shardikgeek/Greenhouse-Auto/README.md

# Greenhouse-Auto
Proyecto de Técnicas Digitales II
