shardikgeek/Greenhouse-Auto/Hardware.txt

Hardware:

Modulo LCD 20x4
Relay (Bomba)
Modulo Puente H (L298M para fan)
Motor paso a paso
Botones
Sensor de humedad del suelo (YL-69)
Sensor de humedad relativa y temperatura (Dht22)
Reloj RTC
