shardikgeek/Greenhouse-Auto/Comandos/Comandos_SAI.docx

Comando | Paquete | Función
Iniciar | :INI,-,-! | Inicia la conversación.
Stop | :STP,-,- | Termina la conversación.
Monitor | :MON,-,ON | Activa el modo monitor.
Monitor | :MON,-,OFF | Desactiva el modo monitor.
Tarjeta presente | :SDC,-,- | Verifica si la tarjeta SD está o no puesta.
Activar cultivo | :TOM,-,- | Comienza el seguimiento de tomate
Activar cultivo | :ZAN,-,- | Comienza el seguimiento de la zanahoria
Modificar temperaturas | :MOD_TEMP,-,ETAPA XX TIPO XX MAX_FAN XX MIN_FAN XX MIN_CAL XX MAX_CAL XX! | Modifica las temperaturas objetivo de una etapa.
Modificar minutos tomate | :MOD_MIN_T,-,E0 XX E1 XX E2 XX! | Modifica los minutos que dura cada etapa.
Modificar minutos zanahoria | :MOD_MIN_Z,-,E0 XX E1 XX E2 XX! | Modifica los minutos que dura la zanahora.
Check temperaturas | :CK_TEMP,-,TOM! | Muestra las temperaturas objetivo de las etapas.
Check minutos | :CK_MIN,-,TOM! | Muestra los minutos de las etapas.
Parar seguimiento | :PAUSE,-,-! | Para el control de temperatura y humedad del seguimiento
Continuar seguimiento | :CONTINUE,-,-! | Habilita el control de temperatura y humedad del seguimiento.
Fecha | :DAY,2,YEAR xx MON xx DATE xx DAY xx HOUR xx MIN xx SEC xx! | Cambia la hora del sistema.
Ventana | :VENT0,-,- | Abrir ventana
Ventana | :VENTC,-,- | Cerrar ventana
Ventana | :STOPV,-,- | Parar ventana
Ventilador | :FAN,-,ON | Prender ventilador
Ventilador | :FAN,-,OFF | Apagar ventilador
Calentador | :CAL,-,ON | Prender calentador
Calentador | :CAL,-,OFF | Apagar calentador
Bomba | :BOMBA,-,ON | Prender Bomba
Bomba | :BOMBA,-,OFF | Apagar Bomba
