shardikgeek/Greenhouse-Auto/Pruebas/Pruebas.md

En esta carpeta se encuentran los codigos para probar cada elemento por separado.
