shardikgeek/Greenhouse-Auto/Pruebas/STM32/STM32.md

Codigos ejemplo y prubeas para la Discovery.
