shardikgeek/Greenhouse-Auto/Pruebas/Maquinas de estado/FSM-MENU.xls

Sheet: State_Table
 |  |  |  | Number of states: |  | 19
 |  |  |  | Number of events: |  | 5
 | menu |  | enter |  | arriba |  | abajo |  | back |  | Event5 |  | Event6 |  | Event7 |  | Event8 |  | Event9 |  | Event10 |  | Event11 |  | Event12 |  | Event13 |  | Event14 |  | Event15 |  | Event16 |  | Event17 |  | Event18 |  | Event19 |  | Event20 |  | Event21 |  | Event22 |  | Event23 |  | Event24 |  | Event25 |  | Event26 |  | Event27 |  | Event28 |  | Event29
 | Function | Next State | Function | Next State | Function | Next State | Function | Next State | Function | Next State | Function | Next State | Function | Next State | Function | Next State | Function | Next State | Function | Next State | Function | Next State | Function | Next State | Function | Next State | Function | Next State | Function | Next State | Function | Next State | Function | Next State | Function | Next State | Function | Next State | Function | Next State | Function | Next State | Function | Next State | Function | Next State | Function | Next State | Function | Next State | Function | Next State | Function | Next State | Function | Next State | Function | Next State | Function
menu_desactivado |  | cultivo |  | menu_desactivado |  | menu_desactivado |  | menu_desactivado |  | menu_desactivado
cultivo |  | menu_desactivado |  | nuevo_cultivo |  | cultivo |  | variables |  | menu_desactivado
variables |  | menu_desactivado |  | humedad |  | cultivo |  | control |  | menu_desactivado
control |  | menu_desactivado |  | bomba |  | variables |  | exportar |  | menu_desactivado
exportar |  | menu_desactivado |  | log |  | control |  | exportar |  | menu_desactivado
nuevo_cultivo |  | menu_desactivado |  | tomate |  | nuevo_cultivo |  | pausar |  | cultivo
pausar |  | menu_desactivado | f_pausar | pausar |  | nuevo_cultivo |  | cancelar |  | cultivo
cancelar |  | menu_desactivado | f_cancelar | cancelar |  | pausar |  | cancelar |  | cultivo
tomate |  | menu_desactivado | f_tomate | tomate |  | tomate |  | zanahoria |  | nuevo_cultivo
zanahoria |  | menu_desactivado | f_zanahoria | zanahoria |  | tomate |  | zanahoria |  | nuevo_cultivo
humedad |  | menu_desactivado | f_humedad | humedad |  | humedad |  | temp_ext |  | variables
temp_ext |  | menu_desactivado | f_temp_ext | temp_ext |  | humedad |  | temp_int |  | variables
temp_int |  | menu_desactivado | f_temp_int | temp_int |  | temp_ext |  | temp_int |  | variables
bomba |  | menu_desactivado | f_bomba | bomba |  | bomba |  | calentador |  | control
calentador |  | menu_desactivado | f_calentador | calentador |  | bomba |  | ventana |  | control
ventana |  | menu_desactivado | f_ventana | ventana |  | calentador |  | ventilador |  | control
ventilador |  | menu_desactivado | f_ventilador | ventilador |  | ventana |  | ventilador |  | control
log |  | menu_desactivado | f_log | log |  | log |  | etapas |  | exportar
etapas |  | menu_desactivado | f_etapas | etapas |  | log |  | etapas |  | exportar
State19
State20
State21
State22
State23
State24
State25
State26
State27
State28
State29
State30
State31

Sheet: fsm_c
//****************************************************************************//
// MSP430 state machine
// fsm.c
//
// Describtion:
// A simple state machine for the MSP430
// Do not change code in here!!!
//
// Generated with Excel Table
// Date: 11/26/2018 Time: 17:47:56
//
//****************************************************************************//
#include <stdint.h>
#include <stdio.h>
#include "fsm.h"
//****************************************************************************//
// Global variables
//****************************************************************************//
uint8_t ActState;
const FSM_STATE_TABLE StateTable [NR_STATES][NR_EVENTS] =
{
NULL, CULTIVO, NULL, MENU_DESACTIVADO, NULL, MENU_DESACTIVADO, NULL, MENU_DESACTIVADO, NULL, MENU_DESACTIVADO,
NULL, MENU_DESACTIVADO, NULL, NUEVO_CULTIVO, NULL, CULTIVO, NULL, VARIABLES, NULL, MENU_DESACTIVADO,
NULL, MENU_DESACTIVADO, NULL, HUMEDAD, NULL, CULTIVO, NULL, CONTROL, NULL, MENU_DESACTIVADO,
NULL, MENU_DESACTIVADO, NULL, BOMBA, NULL, VARIABLES, NULL, EXPORTAR, NULL, MENU_DESACTIVADO,
NULL, MENU_DESACTIVADO, NULL, LOG, NULL, CONTROL, NULL, EXPORTAR, NULL, MENU_DESACTIVADO,
NULL, MENU_DESACTIVADO, NULL, TOMATE, NULL, NUEVO_CULTIVO, NULL, PAUSAR, NULL, CULTIVO,
NULL, MENU_DESACTIVADO, FSM_f_pausar, PAUSAR, NULL, NUEVO_CULTIVO, NULL, CANCELAR, NULL, CULTIVO,
NULL, MENU_DESACTIVADO, FSM_f_cancelar, CANCELAR, NULL, PAUSAR, NULL, CANCELAR, NULL, CULTIVO,
NULL, MENU_DESACTIVADO, FSM_f_tomate, TOMATE, NULL, TOMATE, NULL, ZANAHORIA, NULL, NUEVO_CULTIVO,
NULL, MENU_DESACTIVADO, FSM_f_zanahoria, ZANAHORIA, NULL, TOMATE, NULL, ZANAHORIA, NULL, NUEVO_CULTIVO,
NULL, MENU_DESACTIVADO, FSM_f_humedad, HUMEDAD, NULL, HUMEDAD, NULL, TEMP_EXT, NULL, VARIABLES,
NULL, MENU_DESACTIVADO, FSM_f_temp_ext, TEMP_EXT, NULL, HUMEDAD, NULL, TEMP_INT, NULL, VARIABLES,
NULL, MENU_DESACTIVADO, FSM_f_temp_int, TEMP_INT, NULL, TEMP_EXT, NULL, TEMP_INT, NULL, VARIABLES,
NULL, MENU_DESACTIVADO, FSM_f_bomba, BOMBA, NULL, BOMBA, NULL, CALENTADOR, NULL, CONTROL,
NULL, MENU_DESACTIVADO, FSM_f_calentador, CALENTADOR, NULL, BOMBA, NULL, VENTANA, NULL, CONTROL,
NULL, MENU_DESACTIVADO, FSM_f_ventana, VENTANA, NULL, CALENTADOR, NULL, VENTILADOR, NULL, CONTROL,
NULL, MENU_DESACTIVADO, FSM_f_ventilador, VENTILADOR, NULL, VENTANA, NULL, VENTILADOR, NULL, CONTROL,
NULL, MENU_DESACTIVADO, FSM_f_log, LOG, NULL, LOG, NULL, ETAPAS, NULL, EXPORTAR,
NULL, MENU_DESACTIVADO, FSM_f_etapas, ETAPAS, NULL, LOG, NULL, ETAPAS, NULL, EXPORTAR
};
//****************************************************************************//
// Initialize state machine
//****************************************************************************//
void FSM_Init (void)
{
ActState = MENU_DESACTIVADO;
}
//****************************************************************************//
// Event function "menu"
//****************************************************************************//
void FSM_menu (void)
{
if (StateTable[ActState][MENU].ptrFunct != NULL)
StateTable[ActState][MENU].ptrFunct();
ActState = StateTable[ActState][MENU].NextState;
}
//****************************************************************************//
// Event function "enter"
//****************************************************************************//
void FSM_enter (void)
{
if (StateTable[ActState][ENTER].ptrFunct != NULL)
StateTable[ActState][ENTER].ptrFunct();
ActState = StateTable[ActState][ENTER].NextState;
}
//****************************************************************************//
// Event function "arriba"
//****************************************************************************//
void FSM_arriba (void)
{
if (StateTable[ActState][ARRIBA].ptrFunct != NULL)
StateTable[ActState][ARRIBA].ptrFunct();
ActState = StateTable[ActState][ARRIBA].NextState;
}
//****************************************************************************//
// Event function "abajo"
//****************************************************************************//
void FSM_abajo (void)
{
if (StateTable[ActState][ABAJO].ptrFunct != NULL)
StateTable[ActState][ABAJO].ptrFunct();
ActState = StateTable[ActState][ABAJO].NextState;
}
//****************************************************************************//
// Event function "back"
//****************************************************************************//
void FSM_back (void)
{
if (StateTable[ActState][BACK].ptrFunct != NULL)
StateTable[ActState][BACK].ptrFunct();
ActState = StateTable[ActState][BACK].NextState;
}
//****************************************************************************//

Sheet: fsm_transition_c
//****************************************************************************//
// MSP430 state machine
// fsm_transition.c
//
// Describtion:
// A simple state machine for the MSP430
// You can add your own code in here!!!
//
// Generated with Excel Table
// Date: 11/26/2018 Time: 17:47:56
//
//****************************************************************************//
#include "fsm.h"
//****************************************************************************//
// Transition function "f_pausar"
//****************************************************************************//
void FSM_f_pausar (void)
{
// You can add your code here
}
//****************************************************************************//
// Transition function "f_cancelar"
//****************************************************************************//
void FSM_f_cancelar (void)
{
// You can add your code here
}
//****************************************************************************//
// Transition function "f_tomate"
//****************************************************************************//
void FSM_f_tomate (void)
{
// You can add your code here
}
//****************************************************************************//
// Transition function "f_zanahoria"
//****************************************************************************//
void FSM_f_zanahoria (void)
{
// You can add your code here
}
//****************************************************************************//
// Transition function "f_humedad"
//****************************************************************************//
void FSM_f_humedad (void)
{
// You can add your code here
}
//****************************************************************************//
// Transition function "f_temp_ext"
//****************************************************************************//
void FSM_f_temp_ext (void)
{
// You can add your code here
}
//****************************************************************************//
// Transition function "f_temp_int"
//****************************************************************************//
void FSM_f_temp_int (void)
{
// You can add your code here
}
//****************************************************************************//
// Transition function "f_bomba"
//****************************************************************************//
void FSM_f_bomba (void)
{
// You can add your code here
}
//****************************************************************************//
// Transition function "f_calentador"
//****************************************************************************//
void FSM_f_calentador (void)
{
// You can add your code here
}
//****************************************************************************//
// Transition function "f_ventana"
//****************************************************************************//
void FSM_f_ventana (void)
{
// You can add your code here
}
//****************************************************************************//
// Transition function "f_ventilador"
//****************************************************************************//
void FSM_f_ventilador (void)
{
// You can add your code here
}
//****************************************************************************//
// Transition function "f_log"
//****************************************************************************//
void FSM_f_log (void)
{
// You can add your code here
}
//****************************************************************************//
// Transition function "f_etapas"
//****************************************************************************//
void FSM_f_etapas (void)
{
// You can add your code here
}
//****************************************************************************//

Sheet: fsm_h
//****************************************************************************//
// MSP430 state machine
// fsm.h
//
// Describtion:
// A simple state machine for the MSP430
//
// Generated with Excel Table
// Date: 11/26/2018 Time: 17:47:56
//
//****************************************************************************//
#ifndef FSM_H
#define FSM_H
#include <stdint.h>
#include <stdio.h>
//****************************************************************************//
// State table typedef
//****************************************************************************//
typedef struct
{
void (*ptrFunct) (void);
uint8_t NextState;
} FSM_STATE_TABLE;
extern uint8_t ActState;
#define NR_EVENTS 5
#define MENU 0
#define ENTER 1
#define ARRIBA 2
#define ABAJO 3
#define BACK 4
#define NR_STATES 19
#define MENU_DESACTIVADO 0
#define CULTIVO 1
#define VARIABLES 2
#define CONTROL 3
#define EXPORTAR 4
#define NUEVO_CULTIVO 5
#define PAUSAR 6
#define CANCELAR 7
#define TOMATE 8
#define ZANAHORIA 9
#define HUMEDAD 10
#define TEMP_EXT 11
#define TEMP_INT 12
#define BOMBA 13
#define CALENTADOR 14
#define VENTANA 15
#define VENTILADOR 16
#define LOG 17
#define ETAPAS 18
//****************************************************************************//
// Function prototypes
//****************************************************************************//
// Initialize state machine
void FSM_Init (void);
// Event function "menu"
void FSM_menu (void);
// Event function "enter"
void FSM_enter (void);
// Event function "arriba"
void FSM_arriba (void);
// Event function "abajo"
void FSM_abajo (void);
// Event function "back"
void FSM_back (void);
// Transition function "f_pausar"
void FSM_f_pausar (void);
// Transition function "f_cancelar"
void FSM_f_cancelar (void);
// Transition function "f_tomate"
void FSM_f_tomate (void);
// Transition function "f_zanahoria"
void FSM_f_zanahoria (void);
// Transition function "f_humedad"
void FSM_f_humedad (void);
// Transition function "f_temp_ext"
void FSM_f_temp_ext (void);
// Transition function "f_temp_int"
void FSM_f_temp_int (void);
// Transition function "f_bomba"
void FSM_f_bomba (void);
// Transition function "f_calentador"
void FSM_f_calentador (void);
// Transition function "f_ventana"
void FSM_f_ventana (void);
// Transition function "f_ventilador"
void FSM_f_ventilador (void);
// Transition function "f_log"
void FSM_f_log (void);
// Transition function "f_etapas"
void FSM_f_etapas (void);
//****************************************************************************//
#endif /* FSM_H */
//****************************************************************************//
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
