shardikgeek/Greenhouse-Auto/(list of files, drawings)

Other design files:
Proteus/Placa Madre/Placa Madre.pdsprj
Proteus/Placas Finales/Primera-Placa.pdsprj
Proteus/Placas Finales/Segunda-Placa.pdsprj
Proteus/Reporte_Avance_Alvarez_Loidi_2018_FRBB/Esquematico_Alvarez_Loidi_TDII.pdsprj
