shardikgeek/Greenhouse-Auto/Codigo/SAI_Beta1.0/src/main.c

#include "main.h"

int contador_led = 1000;


int main(void){

	/*	Prototipo 1.3
	 *	Este programa es un prototipo del control de invernadero.
	 *	Tiene RTC, una prueba de seguimiento de cultivos, lee dos sensores externos de temperatura y humedad
	 *	y dos analogicos. 
	 *
	 */

	UB_LCD_2x16_Init(); // Inicializacion del display.
	inicializar_leds();
	inicializar_fan();
	inicializar_ventana();
	inicializar_calentador();
	inicializar_bomba();
	inicializar_nivel_agua();
	adc_inicializar();
	TIM5_Start(); // Inicializa el timer del DHT.
	TIM3_Start(); // Inicializa el timer para el motor paso a paso.
	USART3_Config();

	TM_RTC_Init(TM_RTC_ClockSource_External); // Se inicializa el RTC.
	TM_RTC_Interrupts(TM_RTC_Int_1s); //Se activan las interrupciones del RTC.

	SystemInit(); // Activa el systick.
	SysTick_Config(SystemCoreClock / 1e3); // Configuracion del tiempo de la interrupcion (cada 1us).
	UB_Fatfs_Init(); // Init de la SD.
	FSM_Init(); // Se inicializa la maquina de estados del menu.
	inicializar_botones(); // Inicializa los botones.

	serial.contador = 0;
	serial.flag.comienzo_paquete = 0;
	serial.flag.fin_paquete = 0;
	serial.timeout = 0;
	sistema.flag.conexion_serial = 0;
	sistema.flag.modo_monitor_serial = 0;

	ldr.contador_promedio = 0; // Reset del contador.
	ldr.adc_cuentas_temp = 0; // Reset de la suma del promedio.
	ldr.contador = 101; 		//Cada 5 ms

	tarjeta_sd.flag.fallo_abrir_archivo = 0;
	cultivo.flag.control_activo = 0;
	cargar_datos(); // Se cargan los datos por default.

	control.flag.ventana_abierta = 0;
	control.flag.fan_encendido = 0;
	control.flag.bomba_encendida = 0;
	control.flag.calentador_encendido = 0;
	display.refresh_time = 2001;
	// Offsets de tareas.
	dht_interior.contador = 2501;
	dht_exterior.contador = 3001;
	led.contador = contador_led;
	serial.contador_task = 2501;

	while(1){
		task_manager();
	}
}


/// INICIALIZAIONES

void inicializar_botones(){
	//
	//Inicializacion de los botones.
	//

	GPIO_InitTypeDef GPIO_Init_Pins; // Estrucura de datos para configurar el GPIO

	RCC_AHB1PeriphClockCmd(RCC_AHB1Periph_GPIOD, ENABLE);

	GPIO_Init_Pins.GPIO_Pin = GPIO_Pin_1 + GPIO_Pin_5 + GPIO_Pin_3 + GPIO_Pin_6 + GPIO_Pin_7;
	GPIO_Init_Pins.GPIO_Mode = GPIO_Mode_IN; //Entrada
	GPIO_Init_Pins.GPIO_Speed = GPIO_Speed_100MHz;
	GPIO_Init_Pins.GPIO_OType= GPIO_OType_PP;
	GPIO_Init_Pins.GPIO_PuPd = GPIO_PuPd_UP;

	GPIO_Init(GPIOD, &GPIO_Init_Pins);// Carga de la estrucura de datos.
}

void inicializar_nivel_agua(){
	//
	//Inicializacion de los botones.
	//

	GPIO_InitTypeDef GPIO_Init_Pins; // Estrucura de datos para configurar el GPIO

	RCC_AHB1PeriphClockCmd(RCC_AHB1Periph_GPIOC, ENABLE);

	GPIO_Init_Pins.GPIO_Pin = GPIO_Pin_6;
	GPIO_Init_Pins.GPIO_Mode = GPIO_Mode_IN; //Entrada
	GPIO_Init_Pins.GPIO_Speed = GPIO_Speed_100MHz;
	GPIO_Init_Pins.GPIO_OType= GPIO_OType_PP;
	GPIO_Init_Pins.GPIO_PuPd = GPIO_PuPd_UP;

	GPIO_Init(GPIOC, &GPIO_Init_Pins);// Carga de la estrucura de datos.
}




void inicializar_leds(){
	/*	Funcion inicializar_leds()
	 *	No recive ni devuelve un valor.
	 *	Se inicializan los 4 leds de la placa Discovery STM32F4.
	 */

	GPIO_InitTypeDef GPIO_Init_Pins; // Estrucura de datos para configurar el GPIO

	//
	//Inicializacion de los leds.
	//

	RCC_AHB1PeriphClockCmd(RCC_AHB1Periph_GPIOD, ENABLE);

	GPIO_Init_Pins.GPIO_Pin= GPIO_Pin_15 |GPIO_Pin_12 | GPIO_Pin_13;
	GPIO_Init_Pins.GPIO_Mode=GPIO_Mode_OUT ;
	GPIO_Init_Pins.GPIO_Speed= GPIO_Speed_100MHz;
	GPIO_Init_Pins.GPIO_OType= GPIO_OType_PP ;
	GPIO_Init_Pins.GPIO_PuPd= GPIO_PuPd_NOPULL;

	GPIO_Init(GPIOD,&GPIO_Init_Pins); // Carga de la estrucura de datos.

}

void inicializar_fan(){
	/*	Funcion inicializar_leds()
	 *	No recive ni devuelve un valor.
	 *	Se inicializan los 4 leds de la placa Discovery STM32F4.
	 */

	GPIO_InitTypeDef GPIO_Init_Pins; // Estrucura de datos para configurar el GPIO

	//
	//Inicializacion de los leds.
	//

	RCC_AHB1PeriphClockCmd(RCC_AHB1Periph_GPIOD, ENABLE);

	GPIO_Init_Pins.GPIO_Pin= GPIO_Pin_14;
	GPIO_Init_Pins.GPIO_Mode=GPIO_Mode_OUT ;
	GPIO_Init_Pins.GPIO_Speed= GPIO_Speed_100MHz;
	GPIO_Init_Pins.GPIO_OType= GPIO_OType_PP ;
	GPIO_Init_Pins.GPIO_PuPd= GPIO_PuPd_NOPULL;

	GPIO_Init(GPIOD,&GPIO_Init_Pins); // Carga de la estrucura de datos.

}

void inicializar_ventana()
{
	GPIO_InitTypeDef GPIOA_Stepper;
	RCC_AHB1PeriphClockCmd(RCC_AHB1Periph_GPIOA, ENABLE);

	GPIOA_Stepper.GPIO_Mode = GPIO_Mode_OUT;
	GPIOA_Stepper.GPIO_OType = GPIO_OType_PP;
	GPIOA_Stepper.GPIO_Pin = GPIO_Pin_10|GPIO_Pin_13|GPIO_Pin_14|GPIO_Pin_15;
	GPIOA_Stepper.GPIO_PuPd = GPIO_PuPd_NOPULL;
	GPIOA_Stepper.GPIO_Speed = GPIO_Speed_50MHz;
	GPIO_Init(GPIOA,&GPIOA_Stepper);
}

void inicializar_calentador(){
	/*	Funcion inicializar_leds()
	 *	No recive ni devuelve un valor.
	 *	Se inicializan los 4 leds de la placa Discovery STM32F4.
	 */

	GPIO_InitTypeDef GPIO_Init_Pins; // Estrucura de datos para configurar el GPIO

	//
	//Inicializacion de los leds.
	//

	RCC_AHB1PeriphClockCmd(RCC_AHB1Periph_GPIOC, ENABLE);

	GPIO_Init_Pins.GPIO_Pin= GPIO_Pin_4;
	GPIO_Init_Pins.GPIO_Mode=GPIO_Mode_OUT ;
	GPIO_Init_Pins.GPIO_Speed= GPIO_Speed_100MHz;
	GPIO_Init_Pins.GPIO_OType= GPIO_OType_PP ;
	GPIO_Init_Pins.GPIO_PuPd= GPIO_PuPd_NOPULL;

	GPIO_Init(GPIOC,&GPIO_Init_Pins); // Carga de la estrucura de datos.

}

void inicializar_bomba(){
	/*	Funcion inicializar_leds()
	 *	No recive ni devuelve un valor.
	 *	Se inicializan los 4 leds de la placa Discovery STM32F4.
	 */

	GPIO_InitTypeDef GPIO_Init_Pins; // Estrucura de datos para configurar el GPIO

	//
	//Inicializacion de los leds.
	//

	RCC_AHB1PeriphClockCmd(RCC_AHB1Periph_GPIOC, ENABLE);

	GPIO_Init_Pins.GPIO_Pin= GPIO_Pin_5;
	GPIO_Init_Pins.GPIO_Mode=GPIO_Mode_OUT ;
	GPIO_Init_Pins.GPIO_Speed= GPIO_Speed_100MHz;
	GPIO_Init_Pins.GPIO_OType= GPIO_OType_PP ;
	GPIO_Init_Pins.GPIO_PuPd= GPIO_PuPd_NOPULL;

	GPIO_Init(GPIOC,&GPIO_Init_Pins); // Carga de la estrucura de datos.

}


static void USART3_Config(void)
{
	/*	Funcion USART3_Config
	 * 	Configura los pines necesarios para la conexion a traves de RS232.
	 * 	Ademas inicializa las interrupciones para el USART3 en modo recepcion.
	 */
	GPIO_InitTypeDef GPIO_InitStructure;
	USART_InitTypeDef USART_InitStructure;
	/* USART IOs configuration ***********************************/
	/* Enable GPIOC clock */
	RCC_AHB1PeriphClockCmd(RCC_AHB1Periph_GPIOD, ENABLE);
	/* Connect PC10 to USART3_Tx */
	GPIO_PinAFConfig(GPIOD, GPIO_PinSource8, GPIO_AF_USART3);
	/* Connect PC11 to USART3_Rx*/
	GPIO_PinAFConfig(GPIOD, GPIO_PinSource9, GPIO_AF_USART3);
	/* Configure USART3_Tx and USART3_Rx as alternate function */
	GPIO_InitStructure.GPIO_Pin = GPIO_Pin_8 | GPIO_Pin_9;
	GPIO_InitStructure.GPIO_Mode = GPIO_Mode_AF;
	GPIO_InitStructure.GPIO_Speed = GPIO_Speed_100MHz; // estaba en 50MHz
	GPIO_InitStructure.GPIO_OType = GPIO_OType_PP;
	GPIO_InitStructure.GPIO_PuPd = GPIO_PuPd_UP;
	GPIO_Init(GPIOD, &GPIO_InitStructure);
	/* USART configuration ***************************************/
	/* USART3 configured as follow:
- BaudRate = 115200 baud
- Word Length = 8 Bits
- One Stop Bit
- No parity
- Hardware flow control disabled (RTS and CTS signals)
- Receive and transmit enabled
	 */
	/* Enable USART3 clock */
	RCC_APB1PeriphClockCmd(RCC_APB1Periph_USART3, ENABLE);
	USART_InitStructure.USART_BaudRate = 9600;
	USART_InitStructure.USART_WordLength = USART_WordLength_8b;
	USART_InitStructure.USART_StopBits = USART_StopBits_1;
	USART_InitStructure.USART_Parity = USART_Parity_No;
	USART_InitStructure.USART_HardwareFlowControl = USART_HardwareFlowControl_None;
	USART_InitStructure.USART_Mode = USART_Mode_Rx | USART_Mode_Tx;
	USART_Init(USART3, &USART_InitStructure);
	/* Enable USART3 */
	USART_Cmd(USART3, ENABLE);

	//USART1 is more important than USART2, so it has lower sub priority number
	NVIC_InitTypeDef NVIC_InitStruct;

	NVIC_InitStruct.NVIC_IRQChannel = USART3_IRQn;
	NVIC_InitStruct.NVIC_IRQChannelCmd = ENABLE;
	NVIC_InitStruct.NVIC_IRQChannelPreemptionPriority = 10;
	NVIC_InitStruct.NVIC_IRQChannelSubPriority = 0;
	NVIC_Init(&NVIC_InitStruct);

	USART_ITConfig(USART3, USART_IT_RXNE, ENABLE); // Se habilitan las interrupciones cuando se recibe un dato.
}
///

///	Tareas

void task_scheduler(void){
	/*	Funcion task_scheduler()
	 *	Maneja los contadores de las distintas tareas. Esta funcion es llamada por el systick cada
	 *	vez que se vence su contador (1ms en este caso).
	 *	Cuando el ontador de una tarea llega a su, fin se dispara una bandera de evento.
	 *	Este evento es chequeado luego de la interrupcion generada por el systick en el main().
	 *	Puede haber dos tipos de tareas, ciclicas o no ciclicas. En las ciclicas el
	 *	contador se resetea cada vez q una tarea finaliza, en las no ciclicas el contador
	 *	se setea solo cuando es necesario.
	 */

	// BOTONES
	if(dht_interior.flag == 0 && dht_exterior.flag == 0 && display.flag == 0 && serial.flag.mostrar_valores == 0){

		if(!GPIO_ReadInputDataBit(GPIOD, GPIO_Pin_3))
		{
			if(botones.contador_menu < 15){
				botones.contador_menu++;
				botones.flag.fin_menu = 0;
			}
		}
		else{
			if(botones.contador_menu >= 15){
					GPIO_ToggleBits(GPIOD,GPIO_Pin_15);
					FSM_menu();
					display.flag = 1;
					botones.contador_menu = 0;
					botones.flag.fin_menu = 1; // boton presionado.
			}
		}

		if(!GPIO_ReadInputDataBit(GPIOD, GPIO_Pin_6)){
			if(botones.contador_down < 15){
				botones.contador_down++;
				botones.flag.fin_down = 0; // boton presionado.
			}
		}
		else{
			if(botones.contador_down >= 15){
				GPIO_ToggleBits(GPIOD,GPIO_Pin_15);
				FSM_abajo();
				display.flag = 1;
				botones.contador_down = 0;
				botones.flag.fin_down = 1; // boton presionado.
			}
		}

		if(!GPIO_ReadInputDataBit(GPIOD, GPIO_Pin_5))
		{
			if(botones.contador_back < 15){
				botones.contador_back++;
			}
		}
		else{
			if(botones.contador_back >= 15){
				GPIO_ToggleBits(GPIOD,GPIO_Pin_15);
				FSM_back();
				display.flag = 1;
				botones.contador_back = 0;
				botones.flag.fin_back = 0; // boton presionado.
			}
		}
		if(!GPIO_ReadInputDataBit(GPIOD, GPIO_Pin_7))
		{
			if(botones.contador_up < 15){
				botones.contador_up++;
			}
		}
		else{
			if(botones.contador_up >= 15){
				GPIO_ToggleBits(GPIOD,GPIO_Pin_15);
				FSM_arriba();
				display.flag = 1;
				botones.contador_up = 0;
				botones.flag.fin_up = 0; // boton presionado.
			}
		}

		if(!GPIO_ReadInputDataBit(GPIOD, GPIO_Pin_1))
		{
			if(botones.contador_enter < 15){
				botones.contador_enter++;
			}
		}
		else{
			if(botones.contador_enter >= 15){
				GPIO_ToggleBits(GPIOD,GPIO_Pin_15);
				FSM_enter();
				display.flag = 1;
				botones.contador_enter = 0;
				botones.flag.fin_enter = 0; // boton presionado.
			}
		}

		if((botones.contador_menu + botones.contador_down + botones.contador_up + botones.contador_back + botones.contador_enter) >= 30){
			GPIO_SetBits(GPIOD,GPIO_Pin_12); // Se enciende el led verde si se apretan los botones a la vez.
		}
		else{
			GPIO_ResetBits(GPIOD,GPIO_Pin_12); // Se apaga el led si no se presiona el led o se apreta de a uno a la vez.

		}

		//Nivel de agua.
		if(!GPIO_ReadInputDataBit(GPIOC, GPIO_Pin_6))
		{
			control.flag.agua_tanque = 1;
		}
		else{
			control.flag.agua_tanque = 0;
		}
	}

	//	// Rutina DHT
	if(dht_interior.flag){
		if(dht_interior.timeout >= 1){
			dht_interior.timeout--;
		}

		if(dht_interior.timeout <= 0){
			dht_interior.flag_timeout = 1;
		}
	}

	if(dht_interior.contador >= 1){
		dht_interior.contador--;
	}
	else{
		dht_interior.flag = 1;
		dht_interior.contador = 2501;
		dht_interior.flag_timeout = 0;
		dht_interior.timeout = 1001; // Se le agrega un tiempo de timeout para esperar la funcion DHT11Start.
	}

	if(dht_exterior.flag){
		if(dht_exterior.timeout >= 1){
			dht_exterior.timeout--;
		}

		if(dht_exterior.timeout <= 0){
			dht_exterior.flag_timeout = 1;
		}
	}

	if(dht_exterior.contador >= 1){
		dht_exterior.contador--;
	}
	else{
		dht_exterior.flag = 1;
		dht_exterior.contador = 2501;
		dht_exterior.flag_timeout = 0;
		dht_exterior.timeout = 1001; // Se le agrega un tiempo de timeout para esperar la funcion DHT11Start.
	}
	//
	// Rutina LDR
	if(ldr.contador >= 1){
		ldr.contador--;
	}
	else{
		ldr.flag.fin_contador = 1;
		ldr.contador = 101; 		//Cada 100 mseg
	}

	// Ruitna YL-69
	if(yl.contador >= 1){
		yl.contador--;
	}
	else{
		yl.flag = 1;
		yl.contador = 101;
	}

	// Rutina del LED.
	if(led.contador >= 1){
		led.contador--;
	}
	else{
		led.flag.fin_contador = (led.flag.fin_contador) ? 0 : 1;
		led.contador = contador_led;
	}

	// Rutina display.
	if(display.contador >= 1){
		display.contador--;
	}
	else{
		display.flag = 1;
		display.contador = display.refresh_time;
	}

	// Rutina Serial.
	if(serial.timeout >= 1){
		serial.timeout--;
	}
	else if(serial.flag.comienzo_paquete){
		serial.flag.comienzo_paquete = 0;
		enviar_comando(":TMO,-,-!");
	}

	// Contador para el modo monitor
	if(serial.contador_task >= 1){
		serial.contador_task--;
	}
	else if(sistema.flag.modo_monitor_serial){
		serial.contador_task = 1001;
		serial.flag.mostrar_valores = 1;
	}

	// Contador para chequear cultivo.
	if(cultivo.contador_aux >= 1 && cultivo.flag.control_activo){
		cultivo.contador_aux--;
	}
	else if(cultivo.flag.control_activo){
		cultivo.flag.fin_contador = 1;
		cultivo.contador_aux = 10e3 + 1;
	}
}

void task_manager(void){
	/*	Funcion task_manager
	 *	No recive ni devuelve un valor.
	 * 	Se encarga de llamar a las distintas tareas del programa.
	 *	Estas tareas se realizan o no dependiendo de su flag de evento.
	 */

	menu_task();
//	}else{
//		GPIO_ResetBits(GPIOD,GPIO_Pin_13);
//	}

	// Lectura de datos
	dht_interior_task();
	dht_exterior_task();
	ldr_task();
	yl69_task();
	serial_task();
	display_task(); 		// Manejo de la interfaz de usuario.
	ventana_task();

	// Otras tareas.
	if(!sistema.flag.conexion_serial){ // Se realizan las tareas si no se esta conectado al serial
		led_task();

		// Si se cambia de etapa se cambia el archivo de log.
		if(cultivo.flag.cambio_etapa){
			log_etapas();
			cultivo.flag.cambio_etapa = 0;
		}
	}

	if(cultivo.flag.control_activo){
		if(cultivo.flag.fin_contador){
			datalogger_mejorado();
			cultivo.flag.fin_contador = 0;
		}
		if(!cultivo.flag.pause){
			control_temp_task();
			control_hum_task();
		}
	}



	//	// Si hay una plantacion activa, se controla la temperatura.
	//	if(cultivo.flag.fin_contador){
	//		check_cultivo_task();
	//		cultivo.flag.fin_contador = 0;
	//	}
	//
	//	if(cultivo.flag.control_activo){
	//		control_temp_task();
	//	}
}

void menu_task(){
	char buffer[16];

	if(menu_flags.f_pausa){

		if(cultivo.flag.pause){
			cultivo.flag.pause = 0;
			UB_LCD_2x16_String(0,0,"PAUSA            ");
			UB_LCD_2x16_String(0,1,"DESACTIVADA      ");
			display.contador = 2001;
		}
		else{
			cultivo.flag.pause = 1;
			UB_LCD_2x16_String(0,0,"PAUSA            ");
			UB_LCD_2x16_String(0,1,"ACTIVADA         ");
			if(control.flag.fan_encendido){
				apagar_ventilador();
			}
			if(control.flag.ventana_abierta){
				cerrar_ventana();
			}
			if(control.flag.calentador_encendido){
				GPIO_ResetBits(GPIOC,GPIO_Pin_4);
			}
			if(control.flag.bomba_encendida){
				GPIO_ResetBits(GPIOC,GPIO_Pin_5);
			}

			display.contador = 2001;
		}

		menu_flags.f_pausa = 0;
	}
	if(menu_flags.f_cancelar){
		UB_LCD_2x16_String(0,0,"Cancelar         ");
		UB_LCD_2x16_String(0,1,"                 ");
		display.contador = 2001;
		cultivo.flag.control_activo = 0;
		log_etapas();
		menu_flags.f_cancelar = 0;
	}
	if(menu_flags.f_tomate){
		UB_LCD_2x16_String(0,0,"Configurando     ");
		UB_LCD_2x16_String(0,1,"Tomate           ");
		display.contador = 2001;
		configurar_cultivo_tomate();
		menu_flags.f_tomate = 0;
	}
	if(menu_flags.f_zanahoria){
		UB_LCD_2x16_String(0,0,"Configurando     ");
		UB_LCD_2x16_String(0,1,"Zanahoria        ");
		display.contador = 2001;
		configurar_cultivo_zanahoria();
		menu_flags.f_zanahoria = 0;
	}
	if(menu_flags.f_humedad){
		sprintf(buffer,"Humedad: %d%%  ", yl.humedad);
		UB_LCD_2x16_String(0,0,buffer);
		UB_LCD_2x16_String(0,1,"                 ");
		display.contador = 2001;
		menu_flags.f_humedad = 0;
	}
	if(menu_flags.f_temp_ext){
		UB_LCD_2x16_String(0,0,"Temp-ext         ");
		UB_LCD_2x16_String(9,0,dht_exterior.temperatura_string);
		UB_LCD_2x16_String(0,1,"                 ");
		display.contador = 2001;
		menu_flags.f_temp_ext = 0;
	}
	if(menu_flags.f_temp_int){
		UB_LCD_2x16_String(0,0,"Temp-int         ");
		UB_LCD_2x16_String(9,0,dht_interior.temperatura_string);
		UB_LCD_2x16_String(0,1,"                 ");
		display.contador = 2001;
		menu_flags.f_temp_int = 0;
	}
	if(menu_flags.f_log){
		UB_LCD_2x16_String(0,0,"Escribiendo      ");
		UB_LCD_2x16_String(0,1,"Archivo log...   ");
		display.contador = 2001;
		log_etapas();
		menu_flags.f_log = 0;
	}
	if(menu_flags.f_etapas){
		if(cultivo.flag.control_activo){
			UB_LCD_2x16_String(0,0,"Escribiendo      ");
			UB_LCD_2x16_String(0,1,"Arch. etapas...  ");
			display.contador = 2001;
			backup_etapas();
			menu_flags.f_etapas = 0;
		}
		else{
			UB_LCD_2x16_String(0,0,"Error           ");
			UB_LCD_2x16_String(0,1,"                ");
			display.contador = 2001;
			menu_flags.f_etapas = 0;
		}
	}

	if(menu_flags.f_ventilador){
		if(control.flag.fan_encendido){
			UB_LCD_2x16_String(0,0,"Apagando     ");
			UB_LCD_2x16_String(0,1,"Ventilador      ");
			display.contador = 2001;
			apagar_ventilador();
			control.flag.fan_encendido = 0;
		}
		else{
			UB_LCD_2x16_String(0,0,"Encendiendo     ");
			UB_LCD_2x16_String(0,1,"Ventilador      ");
			display.contador = 2001;
			encender_ventilador();
			control.flag.fan_encendido = 1;
		}
		menu_flags.f_ventilador = 0;
	}

	if(menu_flags.f_ventana){
		if(control.flag.ventana_abierta){
			UB_LCD_2x16_String(0,0,"Cerrando       ");
			UB_LCD_2x16_String(0,1,"Ventana...     ");
			display.contador = 2001;
			cerrar_ventana();
			control.flag.ventana_abierta = 0;
		}
		else{
			UB_LCD_2x16_String(0,0,"Abriendo        ");
			UB_LCD_2x16_String(0,1,"Ventana...      ");
			display.contador = 2001;
			abrir_ventana();
			control.flag.ventana_abierta = 1;
		}
		menu_flags.f_ventana = 0;
	}

	if(menu_flags.f_calentador){
		if(control.flag.calentador_encendido){
			UB_LCD_2x16_String(0,0,"Apagando        ");
			UB_LCD_2x16_String(0,1,"Calentador...   ");
			display.contador = 2001;
			GPIO_ResetBits(GPIOC,GPIO_Pin_4);
			control.flag.calentador_encendido = 0;
		}
		else{
			UB_LCD_2x16_String(0,0,"Encendiendo     ");
			UB_LCD_2x16_String(0,1,"Calentador...   ");
			display.contador = 2001;
			GPIO_SetBits(GPIOC,GPIO_Pin_4);
			control.flag.calentador_encendido = 1;
		}
		menu_flags.f_calentador = 0;
	}

	if(menu_flags.f_bomba){
		if(control.flag.bomba_encendida){
			UB_LCD_2x16_String(0,0,"Apagando        ");
			UB_LCD_2x16_String(0,1,"Bomba...        ");
			display.contador = 2001;
			GPIO_ResetBits(GPIOC,GPIO_Pin_5);
			control.flag.bomba_encendida = 0;
		}
		else{
			UB_LCD_2x16_String(0,0,"Encendiendo     ");
			UB_LCD_2x16_String(0,1,"Bomba...        ");
			display.contador = 2001;
			GPIO_SetBits(GPIOC,GPIO_Pin_5);
			control.flag.bomba_encendida = 1;
		}
		menu_flags.f_bomba = 0;
	}
}

void dht_interior_task(){
	/*	Funcion dht_interior_task()
	 *	No recive ni devuelve un valor.
	 *	Tarea que se encarga de leer los datos del sensor
	 *	DHT11 de temperatura interior.
	 */
	if(dht_interior.flag){
		leer_dht_interior();
		dht_interior.flag = 0;
	}
}

void dht_exterior_task(){
	/*	Funcion dht_exterior_task()
	 *	No recive ni devuelve un valor.
	 *	Tarea que se encarga de leer los datos del sensor
	 *	DHT11 de temperatura eterior.
	 */
	if(dht_exterior.flag){
		leer_dht_exterior();
		dht_exterior.flag = 0;
	}
}

void led_task(){
	/*	Funcion led_task()
	 *	No recive ni devuelve un valor.
	 *	Tarea que se concentra en el parpadeo
	 *	de un led de control de programa.
	 */
	switch(led.flag.fin_contador){
	case 0: GPIO_ResetBits(GPIOD,GPIO_Pin_13);break;
	case 1:	GPIO_SetBits(GPIOD,GPIO_Pin_13);break;
	default:GPIO_ResetBits(GPIOD,GPIO_Pin_13);break;
	}
}

void ldr_task(){
	/*	Funcion ldr_task()
	 *	No recive ni devuelve un valor.
	 *	Tarea que lee un valor de ADC establecido en adc.h.
	 */

	if(ldr.flag.fin_contador){
		ldr.contador_promedio++;

		if(ldr.contador_promedio <= 10){
			ldr.adc_cuentas_temp += adc_leer_cuentas_ldr(); // Se agrega el valor leido a la suma del promedio.
		}
		else{
			ldr.adc_cuentas = ldr.adc_cuentas_temp/10; // Se obtiene el promedio.
			ldr.contador_promedio = 0; // Reset del contador.
			ldr.adc_cuentas_temp = 0; // Reset de la suma del promedio.
		}
		ldr.flag.fin_contador = 0;
	}



	//	if(ldr.flag.fin_contador){
	//		ldr.adc_cuentas = adc_leer_cuentas_ldr(); // Se obtiene el promedio.
	//		ldr.flag.fin_contador = 0;
	//	}


}

void yl69_task(){
	/*	Funcion yl_69_task()
	 *	No recive ni devuelve un valor.
	 *	Tarea que lee un valor de ADC establecido en adc.h
	 */
	if(yl.flag){
		yl.adc_cuentas = adc_leer_cuentas_yl69();
		yl.flag = 0;

		if(yl.adc_cuentas < 640)
		{
			yl.humedad = 100;
		}

		else if(yl.adc_cuentas > 2005)
		{
			yl.humedad = 0;
		}

		else
		{
			yl.humedad = yl.adc_cuentas * (-0.073) + 146.365;
		}
	}
}

void ventana_task(){
	/*	Funcion ventana_task()
	 *	No recive ni devuelve un valor.
	 *	Tarea que lee un valor de ADC establecido en adc.h
	 */
	if(vuelta>N_VUELTAS)
	{
		sentido = 2; //Parar ventana
	}
}

void display_task(){
	/*	Funcion display_task()
	 *	No recive ni devuelve un valor.
	 *	Tarea que lee un valor de ADC establecido en adc.h
	 */
	char buffer[16];
	TM_RTC_GetDateTime(&datatime, TM_RTC_Format_BIN); // Se obtiene la hora actual.

	if(display.flag && ActState == 0){
		display.refresh_time = 2001;
		if(!sistema.flag.conexion_serial){
			//			char buffer[16];

			if(display.estado <2){
				display.estado++;
			}
			else{
				display.estado = 0;
			}

			switch(display.estado){ // Se muestran distintos carteles cada vez que se vence el contador del display.
			case 0:{
				if(cultivo.flag.control_activo){
					sprintf(buffer,"Etapa: %d       ", cultivo.etapa_actual);
					UB_LCD_2x16_String(0,0,buffer);
					UB_LCD_2x16_String(0,1,cultivo.nombre);
					UB_LCD_2x16_String(6,1,"         ");
					display.flag = 0;
				}
				else{
					UB_LCD_2x16_String(0,0,"Sin cultivo     ");
					UB_LCD_2x16_String(0,1,"                ");
					display.flag = 0;
				}
			};break;
			case 1:{

				sprintf(buffer,"     %d:%d      ",datatime.hours,datatime.minutes);
				UB_LCD_2x16_String(0,0,buffer);
				UB_LCD_2x16_String(0,1,"                ");
				display.flag = 0;

			};break;
			case 2:{
				if(cultivo.flag.pause){
					UB_LCD_2x16_String(0,0,"Control         ");
					UB_LCD_2x16_String(0,1,"Desactivado     ");
					display.flag = 0;
				}
				else if(cultivo.flag.control_activo){
					UB_LCD_2x16_String(0,0,"Control         ");
					UB_LCD_2x16_String(0,1,"Activado     ");
					display.flag = 0;
				}
			};break;
			default:{
				UB_LCD_2x16_String(0,0,"Display-fail");
				UB_LCD_2x16_String(0,1,"            ");
				display.flag = 0;
			};break;
			}
			display.flag = 0;
		}
		else{
			UB_LCD_2x16_String(0,0,"Conexion        ");
			UB_LCD_2x16_String(0,1,"PC              ");
			display.flag = 0;
		}

	}
	else if(ActState != 0 && display.flag){ // Si el estado es distinto de desactivado se muestra.
		// Mostrar menu dependiendo el estado.
		switch(ActState){
		    case MENU_DESACTIVADO:{
		    	UB_LCD_2x16_Clear();
		    	UB_LCD_2x16_String(0,0,"Menu Desactivado");
		    };break;
		    case CULTIVO:{
		    	UB_LCD_2x16_String(0,0,"->Cultivo       ");
		    	UB_LCD_2x16_String(0,1,"Variables       ");
		    };break;
		    case VARIABLES:{
		    	UB_LCD_2x16_String(0,0,"Cultivo         ");
		    	UB_LCD_2x16_String(0,1,"->Variables     ");
		    };break;
		    case CONTROL:{
		    	UB_LCD_2x16_String(0,0,"->Control       ");
		    	UB_LCD_2x16_String(0,1,"Exportar        ");
		    };break;
		    case EXPORTAR:{
		    	UB_LCD_2x16_String(0,0,"Control         ");
		    	UB_LCD_2x16_String(0,1,"->Exportar      ");
		    };break;
		    case NUEVO_CULTIVO:{
		    	UB_LCD_2x16_String(0,0,"->Nuevo Cultivo ");
		    	UB_LCD_2x16_String(0,1,"Pausar          ");
		    };break;
		    case PAUSAR:{
		    	UB_LCD_2x16_String(0,0,"Nuevo Cultivo   ");
		    	UB_LCD_2x16_String(0,1,"->Pausar        ");
		    };break;
		    case CANCELAR:{
		    	UB_LCD_2x16_String(0,0,"->Cancelar      ");
		    	UB_LCD_2x16_String(0,1,"                ");
		    };break;
		    case TOMATE:{
		    	UB_LCD_2x16_String(0,0,"->Tomate        ");
		    	UB_LCD_2x16_String(0,1,"Zanahoria");
		    };break;
		    case ZANAHORIA:{
		    	UB_LCD_2x16_String(0,0,"Tomate          ");
		    	UB_LCD_2x16_String(0,1,"->Zanahoria     ");
		    };break;
		    case HUMEDAD:{
		    	UB_LCD_2x16_String(0,0,"->Humedad       ");
		    	UB_LCD_2x16_String(0,1,"Temp Ext        ");
		    };break;
		    case TEMP_EXT:{
		    	UB_LCD_2x16_String(0,0,"Humedad         ");
		    	UB_LCD_2x16_String(0,1,"->Temp Ext      ");
		    };break;
		    case TEMP_INT:{
		    	UB_LCD_2x16_String(0,0,"->Temp Int      ");
		    	UB_LCD_2x16_String(0,1,"                ");
		    };break;
		    case BOMBA:{
		    	UB_LCD_2x16_String(0,0,"->Bomba         ");
		    	UB_LCD_2x16_String(0,1,"Calentador      ");
		    };break;
		    case CALENTADOR:{
		    	UB_LCD_2x16_String(0,0,"Bomba           ");
		    	UB_LCD_2x16_String(0,1,"->Calentador    ");
		    };break;
		    case VENTANA:{
		    	UB_LCD_2x16_String(0,0,"->Ventana       ");
		    	UB_LCD_2x16_String(0,1,"Ventilador      ");
		    };break;
		    case VENTILADOR:{
		    	UB_LCD_2x16_String(0,0,"Ventana         ");
		    	UB_LCD_2x16_String(0,1,"->Ventilador    ");
		    };break;
		    case LOG:{
		    	UB_LCD_2x16_String(0,0,"->Log           ");
		    	UB_LCD_2x16_String(0,1,"Etapas          ");
		    };break;
		    case ETAPAS:{
		    	UB_LCD_2x16_String(0,0,"Log             ");
		    	UB_LCD_2x16_String(0,1,"->Etapas        ");
		    };break;
		    default:{
		    	UB_LCD_2x16_Clear();
		    	UB_LCD_2x16_String(0,0,"CHINGON");
		    };break;
		    }
		display.flag = 0;
		display.refresh_time = 51;
	}
}

void control_temp_task(){
	/*	Control de temperatura
	 * 	Esta funcion controla la temperatura interna del invernadero.
	 */

	if(abs(dht_exterior.temperatura - dht_interior.temperatura) < control.limite_delta_temp){
		// Si se tiene una diferencia de temperatura razonable entre el interior y el exterior se puede abrir la ventana.

		if(dht_interior.temperatura >= control.max_temp_fan){
			if(control.flag.ventana_abierta == 0 && control.flag.fan_encendido == 0 ){
				abrir_ventana();
				encender_ventilador();
				control.flag.ventana_abierta = 1;
				control.flag.fan_encendido = 1;
			}
		}

		else if(dht_exterior.temperatura <= control.min_temp_fan){
			if(control.flag.ventana_abierta == 1 && control.flag.fan_encendido == 1 ){
				cerrar_ventana();
				apagar_ventilador();
				control.flag.ventana_abierta = 0;
				control.flag.fan_encendido = 0;
			}
		}

		if(dht_interior.temperatura <= control.max_temp_calentador){
			GPIO_SetBits(GPIOC,GPIO_Pin_4); // Se enciende el calentador.
			control.flag.calentador_encendido = 1;
		}
		else if(dht_exterior.temperatura >= control.min_temp_calentador){
			GPIO_ResetBits(GPIOC,GPIO_Pin_4);
			control.flag.calentador_encendido = 0;
		}

	}
}
void control_hum_task(void){
	if(yl.humedad <= control.min_hum){
		if(control.flag.agua_tanque){
			GPIO_SetBits(GPIOC,GPIO_Pin_5); // Se enciende la bomba.
			control.flag.bomba_encendida = 1;
		}
	}
	else if(yl.humedad >= control.max_hum){
		GPIO_ResetBits(GPIOC,GPIO_Pin_5); // Se apaga la bomba
		control.flag.bomba_encendida = 0;
	}

	if(control.flag.bomba_encendida && !control.flag.agua_tanque){
		GPIO_ResetBits(GPIOC,GPIO_Pin_5); // Se apaga la bomba
		control.flag.bomba_encendida = 0;
	}
}


// Tarea de serial.
void serial_task(void){
	/*	Funcion serial_task()
	 * 	Se encarga de manejar los paquetes que van ingresando al MCU.
	 * 	Llama a las distintas funciones que se encargan de ejecutar cada comando.
	 */
	char msj[50] = "";

	if(serial.flag.fin_paquete){
		if(!strcmp(serial.comando,"STR") && sistema.flag.conexion_serial){
			GPIO_ToggleBits(GPIOD,GPIO_Pin_14);
			GPIO_ToggleBits(GPIOC,GPIO_Pin_4 |GPIO_Pin_5);
			enviar_comando(":OKK,-,-!\r\n");
		}
		if(!strcmp(serial.comando,"ATR") && sistema.flag.conexion_serial){
			datalogger_mejorado();
			enviar_comando(":OKK,-,-!");
		}
		if(!strcmp(serial.comando,"SKR") && sistema.flag.conexion_serial){
			// Muestra si se pudo leer la tarjeta SD.
			enviar_comando(":OKK,-,-! ");
			cargar_datos();
			if(tarjeta_sd.flag.fallo_abrir_archivo){
				enviar_comando(":SD,4,FAIL!\r\n");
			}
			else{
				enviar_comando(":SD,2,OK!\r\n");
				sprintf(msj,"TIPO_CULTIVO: %d.ESTADO_CULTIVO: %d.ETAPA_CULTIVO: %d.",cultivo.tipo,cultivo.flag.control_activo,cultivo.etapa_actual);
				enviar_comando(msj);
				enviar_comando("\r\n");
				enviar_comando(mensaje_global);
				strcpy(mensaje_global,"");
				enviar_comando("\r\n");
			}
		}
		if(!strcmp(serial.comando,"INI") && !sistema.flag.conexion_serial){
			sistema.flag.conexion_serial = 1;
			enviar_comando(":OKK,-,-!\r\n");
		}
		if(!strcmp(serial.comando,"DAY") && sistema.flag.conexion_serial){
			enviar_comando(":OKK,-,-!\r\n");
			serial_modificar_fecha();
			TM_RTC_SetDateTime(&datatime,TM_RTC_Format_BIN);
		}
		if(!strcmp(serial.comando,"MOD_MIN_T") && sistema.flag.conexion_serial){
			enviar_comando(":OKK,-,-!\r\n");
			serial_modificar_minutos_t();
		}
		if(!strcmp(serial.comando,"MOD_MIN_Z") && sistema.flag.conexion_serial){
			enviar_comando(":OKK,-,-!\r\n");
			serial_modificar_minutos_z();
		}
		if(!strcmp(serial.comando,"MENU") && sistema.flag.conexion_serial){
			enviar_comando(":OKK,-,-!\r\n");
			FSM_menu();
		}
		if(!strcmp(serial.comando,"UP") && sistema.flag.conexion_serial){
			enviar_comando(":OKK,-,-!\r\n");
			FSM_arriba();
		}
		if(!strcmp(serial.comando,"DOWN") && sistema.flag.conexion_serial){
			enviar_comando(":OKK,-,-!\r\n");
			FSM_abajo();
		}
		if(!strcmp(serial.comando,"ENTER") && sistema.flag.conexion_serial){
			enviar_comando(":OKK,-,-!\r\n");
			FSM_enter();
		}
		if(!strcmp(serial.comando,"BACK") && sistema.flag.conexion_serial){
			enviar_comando(":OKK,-,-!\r\n");
			FSM_back();
		}
		if(!strcmp(serial.comando,"STP") && sistema.flag.conexion_serial){
			sistema.flag.conexion_serial = 0;
			sistema.flag.modo_monitor_serial = 0;
			serial.flag.mostrar_valores = 0;
			enviar_comando(":OKK,-,-!\r\n");
		}
		if(!strcmp(serial.comando,"PAUSE") && sistema.flag.conexion_serial){
			cultivo.flag.pause = 1;
			enviar_comando(":OKK,-,-!\r\n");
		}
		if(!strcmp(serial.comando,"CONTINUE") && sistema.flag.conexion_serial){
			cultivo.flag.pause = 0;
			enviar_comando(":OKK,-,-!\r\n");
		}
		if(!strcmp(serial.comando,"LED") && sistema.flag.conexion_serial){
			contador_led = atoi(serial.datos);
			enviar_comando(":OKK,-,-!\r\n");
		}
		if(!strcmp(serial.comando,"DAT") && sistema.flag.conexion_serial){
			cargar_datos();
			enviar_comando(":OKK,-,-!\r\n");
		}
		if(!strcmp(serial.comando,"TOM") && sistema.flag.conexion_serial){
			enviar_comando(":OKK,-,-!\r\n");
			configurar_cultivo_tomate();
		}
		if(!strcmp(serial.comando,"ZAN") && sistema.flag.conexion_serial){
			enviar_comando(":OKK,-,-!\r\n");
			configurar_cultivo_zanahoria();
		}
		if(!strcmp(serial.comando,"LOG") && !strcmp(serial.datos,"LOAD") && sistema.flag.conexion_serial){
			enviar_comando(":OKK,-,-!\r\n");
			log_etapas();
		}
		if(!strcmp(serial.comando,"VENTO") && sistema.flag.conexion_serial){
			abrir_ventana();
			control.flag.ventana_abierta = 1;
			enviar_comando(":OKK,-,-!\r\n");
		}
		if(!strcmp(serial.comando,"VENTC") && sistema.flag.conexion_serial){
			cerrar_ventana();
			control.flag.ventana_abierta = 0;
			enviar_comando(":OKK,-,-!\r\n");
		}
		if(!strcmp(serial.comando,"STOPV") && sistema.flag.conexion_serial){
			parar_ventana();
			enviar_comando(":OKK,-,-!\r\n");
		}
		if(!strcmp(serial.comando,"FAN") && !strcmp(serial.datos,"ON") && sistema.flag.conexion_serial){
			encender_ventilador();
			control.flag.fan_encendido = 1;
			enviar_comando(":OKK,-,-!\r\n");
		}
		if(!strcmp(serial.comando,"FAN") && !strcmp(serial.datos,"OFF") && sistema.flag.conexion_serial){
			apagar_ventilador();
			control.flag.fan_encendido = 0;
			enviar_comando(":OKK,-,-!\r\n");
		}
		if(!strcmp(serial.comando,"CAL") && !strcmp(serial.datos,"ON") && sistema.flag.conexion_serial){
			GPIO_SetBits(GPIOC,GPIO_Pin_4);
			control.flag.calentador_encendido = 1;
			enviar_comando(":OKK,-,-!\r\n");
		}
		if(!strcmp(serial.comando,"CAL") && !strcmp(serial.datos,"OFF") && sistema.flag.conexion_serial){
			GPIO_ResetBits(GPIOC,GPIO_Pin_4);
			control.flag.calentador_encendido = 0;
			enviar_comando(":OKK,-,-!\r\n");
		}
		if(!strcmp(serial.comando,"BOMBA") && !strcmp(serial.datos,"ON") && sistema.flag.conexion_serial){
			GPIO_SetBits(GPIOC,GPIO_Pin_5);
			control.flag.bomba_encendida = 1;
			enviar_comando(":OKK,-,-!\r\n");
		}
		if(!strcmp(serial.comando,"BOMBA") && !strcmp(serial.datos,"OFF") && sistema.flag.conexion_serial){
			GPIO_ResetBits(GPIOC,GPIO_Pin_5);
			control.flag.bomba_encendida = 0;
			enviar_comando(":OKK,-,-!\r\n");
		}
		if(!strcmp(serial.comando,"VAR") && !strcmp(serial.datos,"TEMP") && sistema.flag.conexion_serial){
			sprintf(msj,"VAR: %d,%d,%d\r\n",control.limite_delta_temp,control.max_temp_fan,control.min_temp_fan);
			enviar_comando(msj);
			enviar_comando(":OKK,-,-!\r\n");
		}

		//Comandos para leer los archivos.
		if(!strcmp(serial.comando,"LOG") && !strcmp(serial.datos,"READ") && sistema.flag.conexion_serial){
			enviar_comando(":OKK,-,-!\r\n");
			leer_log();
			enviar_comando("\r\n");
		}
		if(!strcmp(serial.comando,"ETAPAS") && !strcmp(serial.datos,"READ") && sistema.flag.conexion_serial){
			enviar_comando(":OKK,-,-!\r\n");
			leer_etapas();
			enviar_comando("\r\n");
		}


		// Comando para modificar los valroes de temperaturas de las etapas.
		if(!strcmp(serial.comando,"MOD_TEMP") && sistema.flag.conexion_serial){
			serial_modificar_temp();
			enviar_comando(":OKK,-,-!\r\n");
		}
		if(!strcmp(serial.comando,"CK_TEMP") && sistema.flag.conexion_serial){
			if(!strcmp(serial.datos,"TOM")){
				sprintf(msj,"TEMP: %d,%d,%d\r\n",tomate[0].limite_delta_temp,tomate[0].max_temp_calentador,tomate[0].max_temp_fan);
				enviar_comando(msj);
			}
			else if(!strcmp(serial.datos,"ZAN")){
				sprintf(msj,"TEMP: %d,%d,%d\r\n",zanahoria[0].limite_delta_temp,zanahoria[0].max_temp_calentador,zanahoria[0].max_temp_fan);
				enviar_comando(msj);
			}

			enviar_comando(":OKK,-,-!\r\n");
		}
		if(!strcmp(serial.comando,"CK_MIN") && sistema.flag.conexion_serial){
			if(!strcmp(serial.datos,"TOM")){
				sprintf(msj,"Minutos: %d,%d,%d\r\n",tomate_minutos[0],tomate_minutos[1],tomate_minutos[2]);
				enviar_comando(msj);
			}
			else if(!strcmp(serial.datos,"ZAN")){
				sprintf(msj,"Minutos: %d,%d,%d\r\n",zanahoria_minutos[0],zanahoria_minutos[1],zanahoria_minutos[2]);
				enviar_comando(msj);
			}

			enviar_comando(":OKK,-,-!\r\n");
		}


		// Comado SDC SD card Coneccted, se chequea si se puede montar la tarjeta.
		if(!strcmp(serial.comando,"SDC") && sistema.flag.conexion_serial){
			enviar_comando(":OKK,-,-! ");
			if(UB_Fatfs_Mount(MMC_0)==FATFS_OK){
				enviar_comando(":SDC,8,Presente!\r\n");
				UB_Fatfs_UnMount(MMC_0);
			}
			else{
				enviar_comando(":SDC,8,Ausente!\r\n");
			}

		}
		if(!strcmp(serial.comando,"MON") && !strcmp(serial.datos,"ON") && sistema.flag.conexion_serial){
			sistema.flag.modo_monitor_serial = 1;
			enviar_comando(":OKK,-,-!\r\n");
		}
		if(!strcmp(serial.comando,"MON") && !strcmp(serial.datos,"OFF") && sistema.flag.conexion_serial){
			sistema.flag.modo_monitor_serial = 0;
			enviar_comando(":OKK,-,-!\r\n");
		}
	}
	serial.flag.fin_paquete = 0;

	if(sistema.flag.modo_monitor_serial && serial.flag.mostrar_valores){ // Si se esta en modo monitor se muestra el valor cada vez q se
		TM_RTC_GetDateTime(&datatime, TM_RTC_Format_BIN); // Se obtiene la hora actual.
		sprintf(msj,"%d:%d:%d",datatime.hours,datatime.minutes,datatime.seconds);
		enviar_comando(msj);
		enviar_comando(" DHTI: ");										//	vence el contador.
		enviar_comando(dht_interior.temperatura_string);
		enviar_comando(" DHTE: ");										//	vence el contador.
		enviar_comando(dht_exterior.temperatura_string);
		sprintf(msj," ERR-I: %d ERR-E %d", dht_interior.estado,dht_exterior.estado);
		enviar_comando(msj);
		sprintf(msj," LDR: %d", ldr.adc_cuentas);
		enviar_comando(msj);
		sprintf(msj," YL-69: %d, %d %%.AGUA %d\r\n", yl.adc_cuentas,yl.humedad,control.flag.agua_tanque);
		enviar_comando(msj);
		serial.flag.mostrar_valores = 0;
	}
}

/// Funciones de la tarea serial.

// Codigo para USART.
void enviar_comando(char *cmd){
	/*	Funcion enviar_comando
	 * Envia una cadena a traves del USART3
	 */
	uint16_t n = strlen(cmd);
	uint16_t i;
	for(i=0;i<n;i++){
		USART_SendData(USART3, cmd[i]); // Se envia el dato que ingreso.
		while (USART_GetFlagStatus(USART3, USART_FLAG_TC) == RESET); // Se espera a que termine de enviar (NOTAR QUE DICE FLAG).
	}
}


void serial_modificar_temp(){
	//char temp_string[250];
	char *temp;
	uint8_t etapa = 0;
	uint8_t tipo = 0;
	///////////////Codigo que interpreta el texto////////////
	temp = strtok(serial.datos," ,.-");

	while(temp != NULL){
		if(!strcmp("ETAPA",temp)){
			temp = strtok(NULL," ,.-");
			etapa = atoi(temp);
		}
		else if(!strcmp("TIPO",temp)){
			temp = strtok(NULL," ,.-");
			tipo = atoi(temp);
		}
		else if(!strcmp("MAX_FAN",temp)){
			temp = strtok(NULL," ,.-");
			if(tipo == 0)
				tomate[etapa].max_temp_fan = atoi(temp);
			else if(tipo == 1)
				zanahoria[etapa].max_temp_fan = atoi(temp);
		}
		else if(!strcmp("MIN_FAN",temp)){
			temp = strtok(NULL," ,.-");
			if(tipo == 0)
				tomate[etapa].min_temp_fan = atoi(temp);
			else if(tipo == 1)
				zanahoria[etapa].min_temp_fan = atoi(temp);
		}
		else if(!strcmp("MIN_CAL",temp)){
			temp = strtok(NULL," ,.-");
			if(tipo == 0)
				tomate[etapa].min_temp_calentador = atoi(temp);
			else if(tipo == 1)
				zanahoria[etapa].min_temp_calentador = atoi(temp);
		}
		else if(!strcmp("MAX_CAL",temp)){
			temp = strtok(NULL," ,.-");
			if(tipo == 0)
				tomate[etapa].max_temp_calentador = atoi(temp);
			else if(tipo == 1)
				zanahoria[etapa].max_temp_calentador = atoi(temp);
		}
		temp = strtok(NULL," ,.-");

	}
	/////////////////////////////////////////////////////////
}

void serial_modificar_fecha(){
	//char temp_string[250];
	char *temp;
	///////////////Codigo que interpreta el texto////////////
	temp = strtok(serial.datos," ,.-");

	while(temp != NULL){
		if(!strcmp("YEAR",temp)){
			temp = strtok(NULL," ,.-");
			datatime.year = atoi(temp);
		}
		else if(!strcmp("MON",temp)){
			temp = strtok(NULL," ,.-");
			datatime.month = atoi(temp);
		}
		else if(!strcmp("DATE",temp)){
			temp = strtok(NULL," ,.-");
			datatime.date = atoi(temp);
		}
		else if(!strcmp("DAY",temp)){
			temp = strtok(NULL," ,.-");
			datatime.day = atoi(temp);
		}
		else if(!strcmp("HOUR",temp)){
			temp = strtok(NULL," ,.-");
			datatime.hours = atoi(temp);
		}
		else if(!strcmp("MIN",temp)){
			temp = strtok(NULL," ,.-");
			datatime.minutes = atoi(temp);
		}
		else if(!strcmp("SEC",temp)){
			temp = strtok(NULL," ,.-");
			datatime.seconds = atoi(temp);
		}
		temp = strtok(NULL," ,.-");

	}
	/////////////////////////////////////////////////////////
}

void serial_modificar_minutos_t(){
	char *temp;
	///////////////Codigo que interpreta el texto////////////
	temp = strtok(serial.datos," ,.-");

	while(temp != NULL){
		if(!strcmp("E0",temp)){
			temp = strtok(NULL," ,.-");
			tomate_minutos[0] = atoi(temp);
		}
		else if(!strcmp("E1",temp)){
			temp = strtok(NULL," ,.-");
			tomate_minutos[1] = atoi(temp);
		}
		else if(!strcmp("E2",temp)){
			temp = strtok(NULL," ,.-");
			tomate_minutos[2] = atoi(temp);
		}
		temp = strtok(NULL," ,.-");

	}
	/////////////////////////////////////////////////////////
}

void serial_modificar_minutos_z(){
	char *temp;
	///////////////Codigo que interpreta el texto////////////
	temp = strtok(serial.datos," ,.-");

	while(temp != NULL){
		if(!strcmp("E0",temp)){
			temp = strtok(NULL," ,.-");
			zanahoria_minutos[0] = atoi(temp);
		}
		else if(!strcmp("E1",temp)){
			temp = strtok(NULL," ,.-");
			zanahoria_minutos[1] = atoi(temp);
		}
		else if(!strcmp("E2",temp)){
			temp = strtok(NULL," ,.-");
			zanahoria_minutos[2] = atoi(temp);
		}
		temp = strtok(NULL," ,.-");

	}
	/////////////////////////////////////////////////////////
}

void leer_log(){
	FIL myFile;   // Filehandler
	char temp_string[250];
	uint16_t cant_bytes_archivo = 0;
	// se lee el archivo LOG de la sd.
	if(UB_Fatfs_CheckMedia(MMC_0)==FATFS_OK) {
		//GPIO_SetBits(GPIOD,GPIO_Pin_13);
		// Media mounten
		if(UB_Fatfs_Mount(MMC_0)==FATFS_OK) {
			//GPIO_SetBits(GPIOD,GPIO_Pin_12);
			// File zum schreiben im root neu anlegen
			if(UB_Fatfs_OpenFile(&myFile, "0:/LOG.txt", F_RD)==FATFS_OK) {
				// ein paar Textzeilen in das File schreiben
				cant_bytes_archivo = UB_Fatfs_FileSize(&myFile);
				if(UB_Fatfs_ReadString(&myFile,temp_string,cant_bytes_archivo) == FATFS_OK){
					tarjeta_sd.flag.fallo_abrir_archivo = 0;
					enviar_comando(temp_string);

				}
				else{
					tarjeta_sd.flag.fallo_abrir_archivo = 1;
				}
				// File schliessen
				UB_Fatfs_CloseFile(&myFile);
			}
			// Media unmounten
			UB_Fatfs_UnMount(MMC_0);
		}
	}
}

void leer_etapas(){
	FIL myFile;   // Filehandler
	char temp_string[250];
	uint16_t cant_bytes_archivo = 0;
	// se lee el archivo LOG de la sd.
	if(UB_Fatfs_CheckMedia(MMC_0)==FATFS_OK) {
		//GPIO_SetBits(GPIOD,GPIO_Pin_13);
		// Media mounten
		if(UB_Fatfs_Mount(MMC_0)==FATFS_OK) {
			//GPIO_SetBits(GPIOD,GPIO_Pin_12);
			// File zum schreiben im root neu anlegen
			if(UB_Fatfs_OpenFile(&myFile, "0:/ETAPAS.txt", F_RD)==FATFS_OK) {
				// ein paar Textzeilen in das File schreiben
				cant_bytes_archivo = UB_Fatfs_FileSize(&myFile);
				if(UB_Fatfs_ReadString(&myFile,temp_string,cant_bytes_archivo) == FATFS_OK){
					tarjeta_sd.flag.fallo_abrir_archivo = 0;
					enviar_comando(temp_string);
				}
				else{
					tarjeta_sd.flag.fallo_abrir_archivo = 1;
				}
				// File schliessen
				UB_Fatfs_CloseFile(&myFile);
			}
			// Media unmounten
			UB_Fatfs_UnMount(MMC_0);
		}
	}
}
///

///Funciones del control de cultivo.

void configurar_cultivo_tomate(void){
	/*	Funcion configurar_cultivo_tomate()
	 * 	Funcion que inicializa los valores de control de cultivo.
	 *	Se configuran las fechas de las etapas y las variables objetivo para cada una de ellas.
	 *	Ademas se comprueba que las fechas ingresadas sean correctas, si todas lo son se activa el seguimiento.
	 */

	//	uint8_t i,n_etapas_validas = 0;
	//	char msj[30] = "";

	TM_RTC_GetDateTime(&datatime, TM_RTC_Format_BIN); // Se obtiene la hora actual.

	//
	//Se fijan las alarmas y luego se las guarda en la tarjeta SD como backup.
	//

	// configurar_horario_etapa(n_etapa,minutos)
	cultivo.etapa[0].year = datatime.year;
	cultivo.etapa[0].month = datatime.month;
	cultivo.etapa[0].hours = datatime.hours;
	cultivo.etapa[0].minutes = datatime.minutes + MIN_T_ETAPA_0;
	cultivo.etapa[0].seconds = datatime.seconds;
	cultivo.etapa[0].date = datatime.date;
	// Se asegura que la fecha sea valida.
	//	if((datatime.day + 7) > TM_RTC_GetDaysInMonth(datatime.month,datatime.year) ){
	//		cultivo.etapa[0].day = 7 - (TM_RTC_GetDaysInMonth(datatime.month,datatime.year) - datatime.day );
	//	}
	//	else
	//		cultivo.etapa[0].day = datatime.day + 7;

	cultivo.etapa[1].year = datatime.year;
	cultivo.etapa[1].month = datatime.month;
	cultivo.etapa[1].hours = datatime.hours;
	cultivo.etapa[1].minutes = datatime.minutes + MIN_T_ETAPA_0 + MIN_T_ETAPA_1;
	cultivo.etapa[1].seconds = datatime.seconds;
	// Se asegura que la fecha sea valida.
	//	if((datatime.day + 14) > TM_RTC_GetDaysInMonth(datatime.month,datatime.year) ){
	//		cultivo.etapa[1].day = 14 - (TM_RTC_GetDaysInMonth(datatime.month,datatime.year) - datatime.day );
	//	}
	//	else
	//		cultivo.etapa[1].day = datatime.day + 14;
	cultivo.etapa[1].date = datatime.date;

	cultivo.etapa[2].year = datatime.year;
	cultivo.etapa[2].month = datatime.month;
	cultivo.etapa[2].hours = datatime.hours;
	cultivo.etapa[2].minutes = datatime.minutes + MIN_T_ETAPA_0 + MIN_T_ETAPA_1 + MIN_T_ETAPA_2;
	cultivo.etapa[2].seconds = datatime.seconds;
	cultivo.etapa[2].date = datatime.date;
	// Se asegura que la fecha sea valida.
	//	if((datatime.day + 21) > TM_RTC_GetDaysInMonth(datatime.month,datatime.year) ){
	//		cultivo.etapa[2].day = 21 - (TM_RTC_GetDaysInMonth(datatime.month,datatime.year) - datatime.day );
	//	}
	//	else
	//		cultivo.etapa[2].day = datatime.day + 21;

	//
	//  Se guardan los valores de las etapas en la SD
	//
	enviar_comando("C\r\n");
	backup_etapas(); // Se guardan los valoers de las etapas en la SD.
	enviar_comando("F\r\n");

	//
	//  Se cofigura la primer alarma.
	//
	TM_RTC_GetDateTime(&datatime, TM_RTC_Format_BIN); // Se obtiene la hora actual.
	cultivo.etapa_actual = 0;
	AlarmTime.hours = cultivo.etapa[0].hours;
	AlarmTime.minutes = cultivo.etapa[0].minutes;
	AlarmTime.seconds = cultivo.etapa[0].seconds;
	AlarmTime.day = cultivo.etapa[0].date;
	AlarmTime.alarmtype = TM_RTC_AlarmType_DayInMonth;
	TM_RTC_SetAlarm(TM_RTC_Alarm_B, &AlarmTime, TM_RTC_Format_BIN);

	// Se setean las variables de control de a cuerdo a la etapa actual.
	control.limite_delta_temp = tomate[cultivo.etapa_actual].limite_delta_temp;
	control.max_temp_fan = tomate[cultivo.etapa_actual].max_temp_fan;
	control.min_temp_fan = tomate[cultivo.etapa_actual].min_temp_fan;
	control.max_temp_calentador = tomate[cultivo.etapa_actual].max_temp_calentador;
	control.min_temp_calentador = tomate[cultivo.etapa_actual].min_temp_calentador;
	control.max_hum = tomate_h[cultivo.etapa_actual].max_hum;
	control.min_hum = tomate_h[cultivo.etapa_actual].min_hum;

	strcpy(cultivo.nombre,"Tomate"); // Se guarda el nombre del cultivo.
	cultivo.tipo = 0; // Se guarda el tipo de cultivo TOMATE = 0.

	// Se habilitan las banderas de control.
	cultivo.flag.control_activo = 1;
	cultivo.flag.cambio_etapa = 1;
	sistema.flag.first_dat_temp_int = 1;
}

void configurar_cultivo_zanahoria(void){
	/*	Funcion configurar_cultivo_tomate()
	 * 	Funcion que inicializa los valores de control de cultivo.
	 *	Se configuran las fechas de las etapas y las variables objetivo para cada una de ellas.
	 *	Ademas se comprueba que las fechas ingresadas sean correctas, si todas lo son se activa el seguimiento.
	 */

	//	uint8_t i,n_etapas_validas = 0;
	//	char msj[30] = "";

	TM_RTC_GetDateTime(&datatime, TM_RTC_Format_BIN); // Se obtiene la hora actual.

	//
	//Se fijan las alarmas y luego se las guarda en la tarjeta SD como backup.
	//
	cultivo.tipo = 1; // Se guarda el tipo de cultivo TOMATE = 0.
	configurar_horario_etapa(0,tomate_minutos[0]);
	configurar_horario_etapa(1,tomate_minutos[1]);
	configurar_horario_etapa(2,tomate_minutos[2]);

	//
	//  Se guardan los valores de las etapas en la SD
	//
	enviar_comando("C\r\n");
	backup_etapas(); // Se guardan los valoers de las etapas en la SD.
	enviar_comando("F\r\n");

	//
	//  Se cofigura la primer alarma.
	//
	TM_RTC_GetDateTime(&datatime, TM_RTC_Format_BIN); // Se obtiene la hora actual.
	cultivo.etapa_actual = 0;
	AlarmTime.hours = cultivo.etapa[0].hours;
	AlarmTime.minutes = cultivo.etapa[0].minutes;
	AlarmTime.seconds = cultivo.etapa[0].seconds;
	AlarmTime.day = cultivo.etapa[0].date;
	AlarmTime.alarmtype = TM_RTC_AlarmType_DayInMonth;
	TM_RTC_SetAlarm(TM_RTC_Alarm_B, &AlarmTime, TM_RTC_Format_BIN);

	// Se setean las variables de control de a cuerdo a la etapa actual.
	control.limite_delta_temp = zanahoria[cultivo.etapa_actual].limite_delta_temp;
	control.max_temp_fan = zanahoria[cultivo.etapa_actual].max_temp_fan;
	control.min_temp_fan = zanahoria[cultivo.etapa_actual].min_temp_fan;
	control.max_temp_calentador = zanahoria[cultivo.etapa_actual].max_temp_calentador;
	control.min_temp_calentador = zanahoria[cultivo.etapa_actual].min_temp_calentador;
	control.max_hum = zanahoria_h[cultivo.etapa_actual].max_hum;
	control.min_hum = zanahoria_h[cultivo.etapa_actual].min_hum;

	strcpy(cultivo.nombre,"Zanahoria"); // Se guarda el nombre del cultivo.
	cultivo.tipo = 1; // Se guarda el tipo de cultivo TOMATE = 0.

	// Se habilitan las banderas de control.
	cultivo.flag.control_activo = 1;
	cultivo.flag.cambio_etapa = 1;
}

void configurar_horario_etapa(uint8_t n_etapa,uint8_t valor){

	/* Funcion configurar horario etapa
	 * Recibe el numero de la etapa y la cantidad de dias que dura la etapa.
	 * Configura la etapa q es especificada.
	 */
	 uint8_t horas_aux = 0;

	 if(valor <= 60){
		 if((datatime.minutes + valor)>59){
				 cultivo.etapa[n_etapa].minutes = (datatime.minutes + valor) - 60;
				 horas_aux++;
			 }
			 else{
				 cultivo.etapa[n_etapa].minutes = (datatime.minutes + valor);
			 }

			cultivo.etapa[n_etapa].year = datatime.year;
			cultivo.etapa[n_etapa].hours = datatime.hours + horas_aux;
			cultivo.etapa[n_etapa].seconds = datatime.seconds;
			cultivo.etapa[n_etapa].date = datatime.date;
	 }
	 else{
		 cultivo.etapa[n_etapa].year = datatime.year;
		 cultivo.etapa[n_etapa].hours = datatime.hours;
		 cultivo.etapa[n_etapa].seconds = datatime.seconds;
		 cultivo.etapa[n_etapa].minutes = (datatime.minutes + 1);
		 cultivo.etapa[n_etapa].date = datatime.date;
	 }


}




void cargar_datos(){
	/*	Funcion cargar_datos()
	 * 	Esta funcion carga los datos por defecto al sistema de control.
	 * 	De momento los valores se toman de unos arreglos ya predefinidos, la idea es que sean leidos por memoria externa.
	 */
	FIL myFile;   // Filehandler
	char temp_string[250];
	//char string[6] = "Hola";
	char *temp;
	uint8_t estado_cultivo = -1;
	uint8_t etapa_actual = -1;
	uint8_t tipo_cultivo = -1;
	uint8_t etapa_temp = 0;
	TM_RTC_t backup[3];
	uint32_t cant_bytes_archivo = 0;

	// se lee el archivo LOG de la sd.
	if(UB_Fatfs_CheckMedia(MMC_0)==FATFS_OK) {
		//GPIO_SetBits(GPIOD,GPIO_Pin_13);
		// Media mounten
		if(UB_Fatfs_Mount(MMC_0)==FATFS_OK) {
			//GPIO_SetBits(GPIOD,GPIO_Pin_12);
			// File zum schreiben im root neu anlegen
			if(UB_Fatfs_OpenFile(&myFile, "0:/LOG.txt", F_RD)==FATFS_OK) {
				// ein paar Textzeilen in das File schreiben
				cant_bytes_archivo = UB_Fatfs_FileSize(&myFile);
				if(UB_Fatfs_ReadString(&myFile,temp_string,cant_bytes_archivo) == FATFS_OK){
					tarjeta_sd.flag.fallo_abrir_archivo = 0;
					//strcpy(tarjeta_sd.lectura,temp_string);

					///////////////Codigo que interpreta el texto////////////
					temp = strtok(temp_string," ,.-");

					while(temp != NULL){
						if(!strcmp("CULTIVO_ACTIVO",temp)){
							temp = strtok(NULL," ,.-");
							estado_cultivo = atoi(temp);
						}
						else if(!strcmp("ETAPA_CULTIVO",temp)){
							temp = strtok(NULL," ,.-");
							etapa_actual = atoi(temp);
						}
						else if(!strcmp("TIPO_CULTIVO",temp)){
							temp = strtok(NULL," ,.-");
							tipo_cultivo = atoi(temp);
						}
						temp = strtok(NULL," ,.-");

					}
					/////////////////////////////////////////////////////////
				}
				else{
					tarjeta_sd.flag.fallo_abrir_archivo = 1;
				}
				// File schliessen
				UB_Fatfs_CloseFile(&myFile);
			}
			// Media unmounten
			UB_Fatfs_UnMount(MMC_0);
		}
	}


	if(estado_cultivo != -1 && etapa_actual != -1 && tipo_cultivo != -1){ // Se comprueba que el archivo este correcto.

		if(estado_cultivo == 1){ // Si el seguimiento estuvo activo se obtienen las fechas de las etapas.

			// Se lee el archivo ETAPAS de la SD.
			if(UB_Fatfs_CheckMedia(MMC_0)==FATFS_OK) {
				//GPIO_SetBits(GPIOD,GPIO_Pin_13);
				// Media mounten
				if(UB_Fatfs_Mount(MMC_0)==FATFS_OK) {
					//GPIO_SetBits(GPIOD,GPIO_Pin_12);
					// File zum schreiben im root neu anlegen
					if(UB_Fatfs_OpenFile(&myFile, "0:/ETAPAS.txt", F_RD)==FATFS_OK) {
						// ein paar Textzeilen in das File schreiben
						cant_bytes_archivo = UB_Fatfs_FileSize(&myFile);
						if(UB_Fatfs_ReadString(&myFile,temp_string,cant_bytes_archivo) == FATFS_OK){
							tarjeta_sd.flag.fallo_abrir_archivo = 0;
							//strcpy(tarjeta_sd.lectura,temp_string);

							///////////////Codigo que interpreta el texto////////////
							temp = strtok(temp_string," ,.-");

							while(temp != NULL){
								if(!strcmp("ETAPA",temp)){
									temp = strtok(NULL," ,.-");
									etapa_temp = atoi(temp);
								}
								else if(!strcmp("YEAR",temp)){
									temp = strtok(NULL," ,.-");
									backup[etapa_temp].year = atoi(temp);
								}
								else if(!strcmp("MONTH",temp)){
									temp = strtok(NULL," ,.-");
									backup[etapa_temp].month = atoi(temp);
								}
								else if(!strcmp("HOURS",temp)){
									temp = strtok(NULL," ,.-");
									backup[etapa_temp].hours = atoi(temp);
								}
								else if(!strcmp("MINUTES",temp)){
									temp = strtok(NULL," ,.-");
									backup[etapa_temp].minutes = atoi(temp);
								}
								else if(!strcmp("SECONDS",temp)){
									temp = strtok(NULL," ,.-");
									backup[etapa_temp].seconds = atoi(temp);
								}
								else if(!strcmp("DAY",temp)){
									temp = strtok(NULL," ,.-");
									backup[etapa_temp].date = atoi(temp);
								}

								temp = strtok(NULL," ,.-");

							}
							/////////////////////////////////////////////////////////
						}
						else{
							tarjeta_sd.flag.fallo_abrir_archivo = 1;
						}
						// File schliessen
						UB_Fatfs_CloseFile(&myFile);
					}
					// Media unmounten
					UB_Fatfs_UnMount(MMC_0);
				}
			}

			sprintf(mensaje_global,"Etapa %d, YEAR: %d, MONTH %d, HOURS %d, MINUTES %d, SECONDS %d, DAY %d.\r\n", 2,backup[2].year,backup[2].month,backup[2].hours,backup[2].minutes, backup[2].seconds, backup[2].date);
			// Se lee el archivo ETAPAS
			//			sprintf(mensaje_global,"Wacho");

			// Se comprueba si la ultima fecha es valida (por lo tanto todas son validas)
			if(fecha_valida(backup[2])){
				// Se comprueba que la ultima etapa seteada este en una fecha valida, sino se activa la etapa siguiente y asi hasta
				// llegar a una etapa valida.
				//sprintf(mensaje_global,"Fecha valida.");

				while(!fecha_valida(backup[etapa_actual]) && etapa_actual < 3){
					etapa_actual+=1;
				}

				sprintf(mensaje_global,"La etapa seleccionada: %d.", etapa_actual);

				// Se configura la etapa valida.

				cultivo.etapa[0].year = backup[0].year;
				cultivo.etapa[0].month = backup[0].month;
				cultivo.etapa[0].hours = backup[0].hours;
				cultivo.etapa[0].minutes = backup[0].minutes;
				cultivo.etapa[0].seconds = backup[0].seconds;
				cultivo.etapa[0].date = backup[0].date;

				cultivo.etapa[1].year = backup[1].year;
				cultivo.etapa[1].month = backup[1].month;
				cultivo.etapa[1].hours = backup[1].hours;
				cultivo.etapa[1].minutes = backup[1].minutes;
				cultivo.etapa[1].seconds = backup[1].seconds;
				cultivo.etapa[1].date = backup[1].date;

				cultivo.etapa[2].year = backup[2].year;
				cultivo.etapa[2].month = backup[2].month;
				cultivo.etapa[2].hours = backup[2].hours;
				cultivo.etapa[2].minutes = backup[2].minutes;
				cultivo.etapa[2].seconds = backup[2].seconds;
				cultivo.etapa[2].date = backup[2].date;

				// Se cargan las variables del cultivo en el sistema.
				cultivo.flag.control_activo = estado_cultivo;
				cultivo.etapa_actual = etapa_actual;
				cultivo.tipo = tipo_cultivo;

				// Se setean las variables de control de a cuerdo a la etapa actual.
				if(cultivo.tipo == 0){
					control.limite_delta_temp = tomate[cultivo.etapa_actual].limite_delta_temp;
					control.max_temp_fan = tomate[cultivo.etapa_actual].max_temp_fan;
					control.min_temp_fan = tomate[cultivo.etapa_actual].min_temp_fan;
					control.max_temp_calentador = tomate[cultivo.etapa_actual].max_temp_calentador;
					control.min_temp_calentador = tomate[cultivo.etapa_actual].min_temp_calentador;
					strcpy(cultivo.nombre,"Tomate");
				}
				else if(cultivo.tipo == 1){
					control.limite_delta_temp = zanahoria[cultivo.etapa_actual].limite_delta_temp;
					control.max_temp_fan = zanahoria[cultivo.etapa_actual].max_temp_fan;
					control.min_temp_fan = zanahoria[cultivo.etapa_actual].min_temp_fan;
					control.max_temp_calentador = zanahoria[cultivo.etapa_actual].max_temp_calentador;
					control.min_temp_calentador = zanahoria[cultivo.etapa_actual].min_temp_calentador;
					strcpy(cultivo.nombre,"Zanahoria");
				}

				AlarmTime.hours = cultivo.etapa[etapa_actual].hours;
				AlarmTime.minutes = cultivo.etapa[etapa_actual].minutes;
				AlarmTime.seconds = cultivo.etapa[etapa_actual].seconds;
				AlarmTime.day = cultivo.etapa[etapa_actual].date;
				AlarmTime.alarmtype = TM_RTC_AlarmType_DayInMonth;
				TM_RTC_SetAlarm(TM_RTC_Alarm_B, &AlarmTime, TM_RTC_Format_BIN);
			}
			else{
				// Si la fecha no es valida se suspende el seguimiento.
				sprintf(mensaje_global,"Fecha invalida.");
				cultivo.flag.control_activo = 0;
				cultivo.etapa_actual = 0;
			}
			// Se comprueba que la ultima etapa seteada este en una fecha valida, sino se activa la etapa siguiente y asi hasta
			// llegar a una etapa valida.

			// Se configura la etapa valida.
		}
		else{ // Si el seguimiento estuvo desactivado se modifican las banderas necesarias.
			sprintf(mensaje_global,"FALLO");
			cultivo.flag.control_activo = 0;
			cultivo.etapa_actual = 0;
		}

	}
}


// cual?

//configurar_cultivo_tomate();


int fecha_valida(TM_RTC_t fecha_control){
	/*	Funcion fecha_valida()
	 * 	Funcion encargada de retornar si la fecha ingresada en una etapa es valida o no.
	 * 	Si la fecha se encuentra en el pasado es rechazada, si es del futuro se acepta.
	 */

	TM_RTC_GetDateTime(&datatime, TM_RTC_Format_BIN); // Se obtiene la hora actual.

	if(fecha_control.year < datatime.year){
		return 0;
	}
	else if(fecha_control.month < datatime.month){
		return 0;
	}
	else if(fecha_control.date < datatime.date){
		return 0;
	}
	else if(fecha_control.hours < datatime.hours){
		return 0;
	}
	else if(fecha_control.minutes < datatime.minutes){
		return 0;
	}
	else
		return 1;
}


void backup_etapas(void){
	FIL myFile;   // Filehandler
	char temp_string[3][100];

	// Se guardan los horarios de las etapas.
	sprintf(temp_string[0],"-,ETAPA 0, YEAR %d, MONTH %d, HOURS %d, MINUTES %d, SECONDS %d, DAY %d",
			cultivo.etapa[0].year,cultivo.etapa[0].month,cultivo.etapa[0].hours,cultivo.etapa[0].minutes,cultivo.etapa[0].seconds, cultivo.etapa[0].date);
	sprintf(temp_string[1],",ETAPA 1, YEAR %d, MONTH %d, HOURS %d, MINUTES %d, SECONDS %d, DAY %d",
			cultivo.etapa[1].year,cultivo.etapa[1].month,cultivo.etapa[1].hours,cultivo.etapa[1].minutes,cultivo.etapa[1].seconds, cultivo.etapa[1].date);
	sprintf(temp_string[2],",ETAPA 2, YEAR %d, MONTH %d, HOURS %d, MINUTES %d, SECONDS %d, DAY %d.",
			cultivo.etapa[2].year,cultivo.etapa[2].month,cultivo.etapa[2].hours,cultivo.etapa[2].minutes,cultivo.etapa[2].seconds, cultivo.etapa[2].date);
	//sprintf(temp_string,"%d", cultivo.etapa.hours[1]);

	// Check ob Medium eingelegt ist
	if(UB_Fatfs_CheckMedia(MMC_0)==FATFS_OK) {
		//GPIO_SetBits(GPIOD,GPIO_Pin_13);
		// Media mounten
		if(UB_Fatfs_Mount(MMC_0)==FATFS_OK) {
			//GPIO_SetBits(GPIOD,GPIO_Pin_12);
			// File zum schreiben im root neu anlegen
			if(UB_Fatfs_OpenFile(&myFile, "0:/ETAPAS.txt", F_WR_CLEAR)==FATFS_OK) {
				// ein paar Textzeilen in das File schreiben
				UB_Fatfs_WriteString(&myFile,temp_string[0]);
				UB_Fatfs_WriteString(&myFile,temp_string[1]);
				UB_Fatfs_WriteString(&myFile,temp_string[2]);
				// File schliessen
				UB_Fatfs_CloseFile(&myFile);
			}
			// Media unmounten
			UB_Fatfs_UnMount(MMC_0);
		}
	}else{
	}

}

void log_etapas(void){
	FIL myFile;   // Filehandler
	char temp_string[70];
	enviar_comando("ADENTRO\r\n");
	sprintf(temp_string,"-,CULTIVO_ACTIVO %d, ETAPA_CULTIVO %d, TIPO_CULTIVO %d.",cultivo.flag.control_activo,cultivo.etapa_actual, cultivo.tipo);

	// Check ob Medium eingelegt ist
	if(UB_Fatfs_CheckMedia(MMC_0)==FATFS_OK) {
		//GPIO_SetBits(GPIOD,GPIO_Pin_13);
		// Media mounten
		if(UB_Fatfs_Mount(MMC_0)==FATFS_OK) {
			//GPIO_SetBits(GPIOD,GPIO_Pin_12);
			// File zum schreiben im root neu anlegen
			if(UB_Fatfs_OpenFile(&myFile, "0:/Log.txt", F_WR_CLEAR)==FATFS_OK) {
				// ein paar Textzeilen in das File schreiben
				UB_Fatfs_WriteString(&myFile,temp_string);
				// File schliessen
				UB_Fatfs_CloseFile(&myFile);
				enviar_comando("CHLOG\r\n");
			}
			else{
				enviar_comando("FALLO\r\n");
			}
			// Media unmounten
			UB_Fatfs_UnMount(MMC_0);
		}
	}else{

	}
}

void datalogger_mejorado(void){
	FIL myFile;   // Filehandler
	char temp_string[16];
	char temp_msj[100];
	sprintf(temp_string,"0:/TI-%d%d.csv",datatime.date,datatime.hours);
	sprintf(temp_msj,"%d:%d:%d;%s;%s;%d;%d\n",datatime.hours,datatime.minutes,datatime.seconds,dht_interior.temperatura_string,dht_exterior.temperatura_string,yl.humedad,ldr.adc_cuentas);

	// Se chequea que el medio este
	if(UB_Fatfs_CheckMedia(MMC_0)==FATFS_OK) {
		// Se monta el medio
		if(UB_Fatfs_Mount(MMC_0)==FATFS_OK) {

			// Si el archivo ya existe se adhiere la info.
			if(UB_Fatfs_OpenFile(&myFile,temp_string, F_WR)==FATFS_OK) {
				UB_Fatfs_WriteString(&myFile,temp_msj); // Se agrega el nuevo dato.
				enviar_comando("Agregando...\r\n");

				UB_Fatfs_CloseFile(&myFile); // Se cierra el archivo.
			}
			else{
				// Si el archivo no existe se crea uno nuevo.
				if(UB_Fatfs_OpenFile(&myFile,temp_string, F_WR_NEW)==FATFS_OK){
					UB_Fatfs_WriteString(&myFile,"Hora;Temp Int;Temp Ext;Hum Suel;Luz\n"); // Se agregan los titulos de X e Y
					UB_Fatfs_WriteString(&myFile,temp_msj); // Se agrega el nuevo dato.
					enviar_comando("Creando...\r\n");
					UB_Fatfs_CloseFile(&myFile);// Se cierra el archivo.
				}
				else{
					enviar_comando("NOP\r\n");
				}

			}
			// Media unmounten
			UB_Fatfs_UnMount(MMC_0);
		}
	}
}



void activar_alarma(void){
	TM_RTC_GetDateTime(&datatime, TM_RTC_Format_BIN); // Se obtiene la hora actual.
	/* Set alarm B each 20th day in a month */
	/* Alarm will be first triggered 10 seconds later as time is configured for RTC */
	AlarmTime.hours = datatime.hours;
	AlarmTime.minutes = datatime.minutes+1;
	AlarmTime.seconds = datatime.seconds;
	AlarmTime.day = datatime.day;
	AlarmTime.alarmtype = TM_RTC_AlarmType_DayInMonth;
	TM_RTC_SetAlarm(TM_RTC_Alarm_B, &AlarmTime, TM_RTC_Format_BIN);
}

// Handler de interrupciones.

void USART3_IRQHandler(void) {
	/*	Handler USART3_IRQHandler
	 * 	Se encarga de recibir los paquetes a traves del puerto serie.
	 * 	Se asegura que cada paquete tenga su formato correcto. Se esperan caracteres hasta 100ms,
	 * 	despues de este tiempo se toma como un fallo de recepcion.
	 */

	if (USART_GetITStatus(USART3, USART_IT_RXNE)) { // Se limpia la bandera de interrupcion (NOTAR QUE DICE IT)

		serial.aux = USART_ReceiveData(USART3); // Copia el utlimo dato que ingreso.

		if(serial.aux == ':' && !serial.flag.comienzo_paquete){ // Se guarda un paquete si comienza un mensaje con :
			serial.timeout = 100; // Se setea el tiempo maximo de espera.
			serial.contador = 0; // Se reinicia el contador.
			serial.flag.comienzo_paquete = 1; // Se informa el comienzo del paquete.
			serial.flag.fin_paquete = 0; // Se limpia la bandera de fin de paquete.
			strcpy(serial.buffer,""); // Limpia la string.
			strcpy(serial.cant_bytes,""); // Limpia la string.
			strcpy(serial.comando,""); // Limpia la string.
			strcpy(serial.datos,""); // Limpia la string.
		}
		else if((serial.aux == '!' && serial.flag.comienzo_paquete) || serial.contador == 256){ // Se termina paquete con !

			if(!serial.flag.fin_comando || !serial.flag.fin_cantbytes ){
				enviar_comando(":ERR,10,BAD_FORMAT!");
				serial.contador = 0; // Se reinica el contador.
				serial.flag.comienzo_paquete = 0; // Se reinicia la bandera.
				serial.flag.fin_comando = 0; // Se reinicia la bandera.
				serial.flag.fin_cantbytes = 0; // Se reinicia la bandera.
				serial.flag.fin_datos = 0; // Se reinicia la bandera.
				serial.flag.fin_paquete = 0; // Se informa el paquete disponible.
				serial.timeout = 0; // Se detiene el contador de tiempo de espera.
			}
			else{
				strncpy(serial.datos,serial.buffer,256); // Se guardan los datos recibidos.
				strncpy(serial.buffer,"",17); // Se limpia el buffer.
				serial.flag.fin_datos = 1; // Se informa que los datos estan disponibles.
				serial.contador = 0; // Se reinica el contador.
				serial.flag.comienzo_paquete = 0; // Se reinicia la bandera.
				serial.flag.fin_comando = 0; // Se reinicia la bandera.
				serial.flag.fin_cantbytes = 0; // Se reinicia la bandera.
				serial.flag.fin_datos = 0; // Se reinicia la bandera.
				serial.flag.fin_paquete = 1; // Se informa el paquete disponible.
				serial.timeout = 0; // Se detiene el contador de tiempo de espera.
			}
		}
		else if((serial.aux == ',' ) && serial.flag.comienzo_paquete){ // Se detecta el fin de campo.
			serial.timeout = 100; // Se setea el tiempo maximo de espera.
			if(!serial.flag.fin_comando && !serial.flag.fin_cantbytes && !serial.flag.fin_datos){ // Se detecta si es la parte de comando.
				strncpy(serial.comando,serial.buffer,17); // Se guarda el comando.
				strncpy(serial.buffer,"",17); // Se limpia el buffer.
				serial.flag.fin_comando = 1; // Se informa la llegada del comando.
			}
			else if(serial.flag.fin_comando && !serial.flag.fin_cantbytes && !serial.flag.fin_datos){ // Se detecta si es la parte de cantidad de bytes.
				strncpy(serial.cant_bytes,serial.buffer,17); // Se guarda la cantidad de bytes.
				strncpy(serial.buffer,"",17); // Se limpia el buffer.
				serial.flag.fin_cantbytes = 1;  // Se informa la llegada de la cantidad de bytes.
			}
			serial.contador = 0; // Se reinica el contador para guardar el proximo campo.
		}
		else if((serial.aux != ':' && serial.aux != '!' ) && serial.flag.comienzo_paquete){ // Se agrega un caracter al buffer.
			serial.timeout = 100; // Se setea el tiempo maximo de espera.
			serial.buffer[serial.contador] = serial.aux; // Se guarda el caracter.
			serial.contador++;
		}

		//Clear interrupt flag
		USART_ClearITPendingBit(USART3, USART_IT_RXNE); // Se limpia la bandera de interrupcion (NOTAR QUE DICE IT)
	}
}

void TM_RTC_AlarmBHandler(void) {
	/* If user needs this function, then they should be defined separatelly in your project */
	if(cultivo.etapa_actual < 2){
		enviar_comando("Cambiando etapa...\r\n");
		cultivo.etapa_actual++;
		cultivo.flag.cambio_etapa = 1; // Se avisa el cambio de etapa para cambiar el archivo de log.
		// Se setean las variables de control de a cuerdo a la etapa actual.
		if(cultivo.tipo == 0){
			control.limite_delta_temp = tomate[cultivo.etapa_actual].limite_delta_temp;
			control.max_temp_fan = tomate[cultivo.etapa_actual].max_temp_fan;
			control.min_temp_fan = tomate[cultivo.etapa_actual].min_temp_fan;
			control.max_temp_calentador = tomate[cultivo.etapa_actual].max_temp_calentador;
			control.min_temp_calentador = tomate[cultivo.etapa_actual].min_temp_calentador;
			control.max_hum = tomate_h[cultivo.etapa_actual].max_hum;
			control.min_hum = tomate_h[cultivo.etapa_actual].min_hum;
		}
		else if(cultivo.tipo == 1){
			control.limite_delta_temp = zanahoria[cultivo.etapa_actual].limite_delta_temp;
			control.max_temp_fan = zanahoria[cultivo.etapa_actual].max_temp_fan;
			control.min_temp_fan = zanahoria[cultivo.etapa_actual].min_temp_fan;
			control.max_temp_calentador = zanahoria[cultivo.etapa_actual].max_temp_calentador;
			control.min_temp_calentador = zanahoria[cultivo.etapa_actual].min_temp_calentador;
			control.max_hum = zanahoria_h[cultivo.etapa_actual].max_hum;
			control.min_hum = zanahoria_h[cultivo.etapa_actual].min_hum;
		}

		AlarmTime.hours = cultivo.etapa[cultivo.etapa_actual].hours;
		AlarmTime.minutes = cultivo.etapa[cultivo.etapa_actual].minutes;
		AlarmTime.seconds = cultivo.etapa[cultivo.etapa_actual].seconds;
		AlarmTime.day = cultivo.etapa[cultivo.etapa_actual].date;
		AlarmTime.alarmtype = TM_RTC_AlarmType_DayInMonth;
		TM_RTC_SetAlarm(TM_RTC_Alarm_B, &AlarmTime, TM_RTC_Format_BIN);


	}
	else{
		/* Set RTC alarm B, time in binary format */
		cultivo.etapa_actual = 0;
		cultivo.flag.control_activo = 0;
		cultivo.flag.cambio_etapa = 1; // Se avisa el cambio de etapa para cambiar el archivo de log.
		enviar_comando("ALARMA B DESCTIVADA\r\n");
		TM_RTC_DisableAlarm(TM_RTC_Alarm_B);
		if(control.flag.fan_encendido){
			apagar_ventilador();
		}
		if(control.flag.ventana_abierta){
			cerrar_ventana();
		}
		if(control.flag.calentador_encendido){
			GPIO_ResetBits(GPIOC,GPIO_Pin_4);
		}
		if(control.flag.bomba_encendida){
			GPIO_ResetBits(GPIOC,GPIO_Pin_5);
		}
	}
	/* Disable Alarm so it will not trigger next month at the same date and time */
	//TM_RTC_DisableAlarm(TM_RTC_Alarm_B);
}
