shardikgeek/Greenhouse-Auto/Codigo/SAI_Beta1.0/src/dht.h

/*
 * dht.h
 *	Esta libreria utiliza el TIMER 5 para realizar un peque�o delay.
 *
 *  Created on: 11 ago. 2018
 *      Author: diego
 */
// Pin 1 GPIOA DHT11
#ifndef DHT_H_
#define DHT_H_
#include <stm32f4xx.h>
#include <stdio.h>
#include <stdlib.h>
#include <string.h>
#define TIME_TIMEOUT 30

#define STATE_DHT_TIMEOUT 4
#define STATE_DHT_DESCONECTADO 1
#define STATE_DHT_CHECKSUM_GOOD 2
#define STATE_DHT_CHECKSUM_BAD 3

uint32_t TimingDelay = 0;

struct{
	uint32_t contador;
	uint32_t contador_desconectado;
	uint8_t flag;
	uint8_t check;
	uint32_t timeout;
	uint8_t flag_timeout;
	uint8_t estado;
	char temperatura_string[15];
	double temperatura;
	double humedad;
}dht_interior;

struct{
	uint32_t contador;
	uint32_t contador_desconectado;
	uint8_t flag;
	uint8_t check;
	uint32_t timeout;
	uint8_t flag_timeout;
	uint8_t estado;
	char temperatura_string[15];
	double temperatura;
	double humedad;
}dht_exterior;

void DHT11_start_interior(void);
void set_gpio_output_interior(void);
void set_gpio_input_interior(void);
void check_response_interior(void);
uint8_t read_data_interior(void);
void leer_dht_interior();

void DHT11_start_exterior(void);
void set_gpio_output_exterior(void);
void set_gpio_input_exterior(void);
void check_response_exterior(void);
uint8_t read_data_exterior(void);
void leer_dht_exterior();

void delay(uint32_t tiempo);
void TIM5_Start(void);

void delay(uint32_t tiempo){
	/* Funcion delay()
	 * Realiza un retardo en funcion de la frecuencia de reloj del microcontrolador.
	 * Recibe como parametro el retraso, para este caso, en mS debido a la configuracion del Systick.
	 */

	TimingDelay = tiempo;
	while(TimingDelay!=0);

}


// DHT INTERIOR

void set_gpio_output_interior(void)
{
	GPIO_InitTypeDef GPIO_Init_Pins; // Estrucura de datos para configurar el GPIO

	//
	//Inicializacion del pin.
	//

	RCC_AHB1PeriphClockCmd(RCC_AHB1Periph_GPIOE, ENABLE);

	GPIO_Init_Pins.GPIO_Pin= GPIO_Pin_7;
	GPIO_Init_Pins.GPIO_Mode=GPIO_Mode_OUT ;
	GPIO_Init_Pins.GPIO_Speed= GPIO_Speed_100MHz;
	GPIO_Init_Pins.GPIO_OType= GPIO_OType_PP ;
	GPIO_Init_Pins.GPIO_PuPd= GPIO_PuPd_NOPULL;

	GPIO_Init(GPIOE,&GPIO_Init_Pins); // Carga de la estrucura de datos.
}

void set_gpio_input_interior (void)
{
	GPIO_InitTypeDef GPIO_Init_Pins; // Estrucura de datos para configurar el GPIO

	//
	//Inicializacion del pin.
	//

	RCC_AHB1PeriphClockCmd(RCC_AHB1Periph_GPIOE, ENABLE);

	GPIO_Init_Pins.GPIO_Pin= GPIO_Pin_7;
	GPIO_Init_Pins.GPIO_Mode=GPIO_Mode_IN;
	GPIO_Init_Pins.GPIO_Speed= GPIO_Speed_100MHz;
	GPIO_Init_Pins.GPIO_OType= GPIO_OType_PP;
	GPIO_Init_Pins.GPIO_PuPd= GPIO_PuPd_NOPULL;

	GPIO_Init(GPIOE,&GPIO_Init_Pins); // Carga de la estrucura de datos.
}

void DHT11_start_interior (void)
{
	set_gpio_output_interior();  // set the pin as output
	GPIO_WriteBit(GPIOE,GPIO_Pin_7,0); // pull the pin low
	delay(18000);   // wait for 18ms
	set_gpio_input_interior();   // set as input
}

void check_response_interior (void)
{
	delay(40);
	if (!(GPIO_ReadInputDataBit(GPIOE,GPIO_Pin_7)))
	{
		delay(80);
		if ((GPIO_ReadInputDataBit(GPIOE,GPIO_Pin_7))) dht_interior.check = 1;
	}

	dht_interior.timeout = TIME_TIMEOUT;
	while (GPIO_ReadInputDataBit(GPIOE,GPIO_Pin_7) && !dht_interior.flag_timeout);   // wait for the pin to go low
}

uint8_t read_data_interior (void)
{
	uint8_t i,j;
	for (j=0;j<8;j++)
	{
		dht_interior.timeout = TIME_TIMEOUT;
		while (!(GPIO_ReadInputDataBit(GPIOE,GPIO_Pin_7)) && !dht_interior.flag_timeout);   // wait for the pin to go high
		if(dht_interior.flag_timeout)  //Si se vencio el timeout vuelve al main.
					return 0;

		delay(40);   // wait for 40 us

		if ((GPIO_ReadInputDataBit(GPIOE,GPIO_Pin_7)) == 0)   // if the pin is low
		{
			i&= ~(1<<(7-j));   // write 0
		}
		else i|= (1<<(7-j));  // if the pin is high, write 1

		dht_interior.timeout = TIME_TIMEOUT; // set the timeout
		while ((GPIO_ReadInputDataBit(GPIOE,GPIO_Pin_7)) && !dht_interior.flag_timeout);  // wait for the pin to go low or the timeout dead.
		if(dht_interior.flag_timeout)  //Si se vencio el timeout vuelve al main.
					return 0;
	}
	return i;
}

void leer_dht_interior(){

	uint8_t Rh_byte1, Rh_byte2, Temp_byte1, Temp_byte2;
	uint16_t sum;
	char aux[5] = "";

	TIM_Cmd(TIM5, ENABLE); // Habilita el timer 5 para la lectura.
	DHT11_start_interior ();


	check_response_interior ();
	//	GPIO_ToggleBits(GPIOD,GPIO_Pin_12);
	if(dht_interior.flag_timeout){ //Si se vencio el timeout vuelve al main.
		dht_interior.estado = STATE_DHT_TIMEOUT;
		TIM_Cmd(TIM5, DISABLE);
		return;
	}

	Rh_byte1 = read_data_interior ();
	if(dht_interior.flag_timeout){ //Si se vencio el timeout vuelve al main.
		dht_interior.estado = STATE_DHT_TIMEOUT;
		TIM_Cmd(TIM5, DISABLE);
		return;
	}

	Rh_byte2 = read_data_interior ();
	if(dht_interior.flag_timeout){ //Si se vencio el timeout vuelve al main.
		dht_interior.estado = STATE_DHT_TIMEOUT;
		TIM_Cmd(TIM5, DISABLE);
		return;
	}

	Temp_byte1 = read_data_interior ();
	if(dht_interior.flag_timeout){ //Si se vencio el timeout vuelve al main.
		dht_interior.estado = STATE_DHT_TIMEOUT;
		TIM_Cmd(TIM5, DISABLE);
		return;
	}

	Temp_byte2 = read_data_interior ();
	if(dht_interior.flag_timeout){ //Si se vencio el timeout vuelve al main.
		dht_interior.estado = STATE_DHT_TIMEOUT;
		TIM_Cmd(TIM5, DISABLE);
		return;
	}

	sum = read_data_interior();
	if(dht_interior.flag_timeout){ //Si se vencio el timeout vuelve al main.
		dht_interior.estado = STATE_DHT_TIMEOUT;
		TIM_Cmd(TIM5, DISABLE);
		return;
	}

	if (sum == (Rh_byte1+Rh_byte2+Temp_byte1+Temp_byte2))    // if the data is correct
	{
		sprintf(aux,"%d,%d",Temp_byte1,Temp_byte2); // Se crea una cadena con la temperatura.
		strcpy(dht_interior.temperatura_string,aux); // Se guarda la temperatura en la estructura del dht.
		dht_interior.temperatura = Temp_byte1 + Temp_byte2/10;
		dht_interior.estado = STATE_DHT_CHECKSUM_GOOD; // Se cambia el estado del sensor.
	}
	else
		dht_interior.estado = STATE_DHT_CHECKSUM_BAD; // Se cambia el estado del sensor.

	TIM_Cmd(TIM5, DISABLE);

}

// DHT Exterior.

void set_gpio_output_exterior(void)
{
	GPIO_InitTypeDef GPIO_Init_Pins; // Estrucura de datos para configurar el GPIO

	//
	//Inicializacion del pin.
	//

	RCC_AHB1PeriphClockCmd(RCC_AHB1Periph_GPIOE, ENABLE);

	GPIO_Init_Pins.GPIO_Pin= GPIO_Pin_9;
	GPIO_Init_Pins.GPIO_Mode=GPIO_Mode_OUT ;
	GPIO_Init_Pins.GPIO_Speed= GPIO_Speed_100MHz;
	GPIO_Init_Pins.GPIO_OType= GPIO_OType_PP ;
	GPIO_Init_Pins.GPIO_PuPd= GPIO_PuPd_NOPULL;

	GPIO_Init(GPIOE,&GPIO_Init_Pins); // Carga de la estrucura de datos.
}

void set_gpio_input_exterior (void)
{
	GPIO_InitTypeDef GPIO_Init_Pins; // Estrucura de datos para configurar el GPIO

	//
	//Inicializacion del pin.
	//

	RCC_AHB1PeriphClockCmd(RCC_AHB1Periph_GPIOE, ENABLE);

	GPIO_Init_Pins.GPIO_Pin= GPIO_Pin_9;
	GPIO_Init_Pins.GPIO_Mode=GPIO_Mode_IN;
	GPIO_Init_Pins.GPIO_Speed= GPIO_Speed_100MHz;
	GPIO_Init_Pins.GPIO_OType= GPIO_OType_PP;
	GPIO_Init_Pins.GPIO_PuPd= GPIO_PuPd_NOPULL;

	GPIO_Init(GPIOE,&GPIO_Init_Pins); // Carga de la estrucura de datos.
}

void DHT11_start_exterior (void)
{
	set_gpio_output_exterior();  // set the pin as output
	GPIO_WriteBit(GPIOE,GPIO_Pin_9,0); // pull the pin low
	delay(18000);   // wait for 18ms
	set_gpio_input_exterior();   // set as input
}

void check_response_exterior (void)
{
	delay(40);
	if (!(GPIO_ReadInputDataBit(GPIOE,GPIO_Pin_9)))
	{
		delay(80);
		if ((GPIO_ReadInputDataBit(GPIOE,GPIO_Pin_9))) dht_exterior.check = 1;
	}

	dht_exterior.timeout = TIME_TIMEOUT;
	while (GPIO_ReadInputDataBit(GPIOE,GPIO_Pin_9) && !dht_exterior.flag_timeout);   // wait for the pin to go low
}

uint8_t read_data_exterior (void)
{
	uint8_t i,j;
	for (j=0;j<8;j++)
	{
		dht_exterior.timeout = TIME_TIMEOUT;
		while (!(GPIO_ReadInputDataBit(GPIOE,GPIO_Pin_9)) && !dht_exterior.flag_timeout);   // wait for the pin to go high
		if(dht_exterior.flag_timeout)  //Si se vencio el timeout vuelve al main.
			return 0;

		delay(40);   // wait for 40 us

		if ((GPIO_ReadInputDataBit(GPIOE,GPIO_Pin_9)) == 0)   // if the pin is low
		{
			i&= ~(1<<(7-j));   // write 0
		}
		else i|= (1<<(7-j));  // if the pin is high, write 1

		dht_exterior.timeout = TIME_TIMEOUT; // set the timeout
		while ((GPIO_ReadInputDataBit(GPIOE,GPIO_Pin_9)) && !dht_exterior.flag_timeout);  // wait for the pin to go low or the timeout dead.
		if(dht_exterior.flag_timeout)  //Si se vencio el timeout vuelve al main.
			return 0;
	}
	return i;
}

void leer_dht_exterior(){

	uint8_t Rh_byte1, Rh_byte2, Temp_byte1, Temp_byte2;
	uint16_t sum;
	char aux[5] = "";

	TIM_Cmd(TIM5, ENABLE); // Habilita el timer 5 para la lectura.
	DHT11_start_exterior ();


	check_response_exterior ();
	//	GPIO_ToggleBits(GPIOD,GPIO_Pin_12);
	if(dht_exterior.flag_timeout){ //Si se vencio el timeout vuelve al main.
		dht_exterior.estado = STATE_DHT_TIMEOUT;
		TIM_Cmd(TIM5, DISABLE);
		return;
	}

	Rh_byte1 = read_data_exterior ();
	if(dht_exterior.flag_timeout){ //Si se vencio el timeout vuelve al main.
		dht_exterior.estado = STATE_DHT_TIMEOUT;
		TIM_Cmd(TIM5, DISABLE);
		return;
	}

	Rh_byte2 = read_data_exterior ();
	if(dht_exterior.flag_timeout){ //Si se vencio el timeout vuelve al main.
		dht_exterior.estado = STATE_DHT_TIMEOUT;
		TIM_Cmd(TIM5, DISABLE);
		return;
	}

	Temp_byte1 = read_data_exterior ();
	if(dht_exterior.flag_timeout){ //Si se vencio el timeout vuelve al main.
		dht_exterior.estado = STATE_DHT_TIMEOUT;
		TIM_Cmd(TIM5, DISABLE);
		return;
	}

	Temp_byte2 = read_data_exterior ();
	if(dht_exterior.flag_timeout){ //Si se vencio el timeout vuelve al main.
		dht_exterior.estado = STATE_DHT_TIMEOUT;
		TIM_Cmd(TIM5, DISABLE);
		return;
	}

	sum = read_data_exterior();
	if(dht_exterior.flag_timeout){ //Si se vencio el timeout vuelve al main.
		dht_exterior.estado = STATE_DHT_TIMEOUT;
		TIM_Cmd(TIM5, DISABLE);
		return;
	}

	if (sum == (Rh_byte1+Rh_byte2+Temp_byte1+Temp_byte2))    // if the data is correct
	{
		sprintf(aux,"%d,%d",Temp_byte1,Temp_byte2); // Se crea una cadena con la temperatura.
		strcpy(dht_exterior.temperatura_string,aux); // Se guarda la temperatura en la estructura del dht.
		dht_exterior.temperatura = Temp_byte1 + Temp_byte2/10;;
		dht_exterior.estado = STATE_DHT_CHECKSUM_GOOD; // Se cambia el estado del sensor.
	}
	else
		dht_exterior.estado = STATE_DHT_CHECKSUM_BAD; // Se cambia el estado del sensor.

	TIM_Cmd(TIM5, DISABLE);

}



/////////////////////////// TIMER 5/////////////////////////////
void TIM5_Init(void){
	/*
	 *	TIMX_Init Configura los parametros del timer X.
	 *	Formulas:
	 *	TIM3CLK = 84MHz. Reloj del timer, para modiicarlo hay que cambiar el archivo system_stm32f4xx.c .
	 *	frecuencia. Frecuencia a la que cuenta el timer, este valor modifica el prescaler.
	 *	TIM_Period = (Tei*TIM3CLK)/(Prescalervalue+1). Tei es el valor de periodo de interrupcion deseado en segundos.
	 *
	 *	ATENCION: TIM_Period y PrescalerValue no deben superar el valor de 0xFFFF (65536) ya que son de 16bits.
	 */

	TIM_TimeBaseInitTypeDef  TIM_TimeBaseStructure;
	uint16_t PrescalerValue = 0; // Variable para el prescaler.
	uint32_t frecuencia = 10e6; // Frecuencia del contador a 10kHz. Tener cuidado de no cometer overflow en la variable PrescalerValue.
	PrescalerValue = (uint16_t) ((SystemCoreClock /2) / frecuencia) - 1; //Conversion de frecuencia al valor de Prescaler.
	TIM_TimeBaseStructure.TIM_Period = 10; // 321.5uS (10e3 = 1 seg --> 3.215 = 321.5uS) de periodo.
	TIM_TimeBaseStructure.TIM_Prescaler = PrescalerValue;
	TIM_TimeBaseStructure.TIM_ClockDivision = 0;
	TIM_TimeBaseStructure.TIM_CounterMode = TIM_CounterMode_Up;

	TIM_TimeBaseInit(TIM5, &TIM_TimeBaseStructure);
	TIM_ITConfig(TIM5, TIM_IT_CC1, ENABLE); // habilitacion de las interrupciones por el timer 5.
	TIM_Cmd(TIM5, ENABLE); // Habilita el contador para el timer 5.

}

void TIM5_Config(void){
	/*
	 *	TIMX_Config habilita el relog y las interrupciones globales para el timer X
	 */

	NVIC_InitTypeDef NVIC_InitStructure;

	RCC_APB1PeriphClockCmd(RCC_APB1Periph_TIM5, ENABLE); // Se habilita el reloj.

	/* Se habilitan las interrupciones globales para el timer X*/
	NVIC_InitStructure.NVIC_IRQChannel = TIM5_IRQn;
	NVIC_InitStructure.NVIC_IRQChannelPreemptionPriority = 10;
	NVIC_InitStructure.NVIC_IRQChannelSubPriority = 1;
	NVIC_InitStructure.NVIC_IRQChannelCmd = ENABLE;
	NVIC_Init(&NVIC_InitStructure);

}

void TIM5_Start(void){
	/*
	 *	TIMX_Start deja el timer X ready to go.
	 */

	TIM5_Config(); // Configuracion del timer.
	TIM5_Init(); // Inicializacion del timer.
	TIM_Cmd(TIM5, DISABLE);
}

void TIM5_IRQHandler (void)  {
	/* TIM5_IRQHandler rutina de interrupcion del timer 5.
	 *  Realiza un toogle en el led azul de la placa discovery.
	 */

	if (TIM_GetITStatus(TIM5, TIM_IT_CC1) != RESET)
	{
		TIM_ClearITPendingBit(TIM5, TIM_IT_CC1); // Se limpia la bandera de interrupcion.

		if (TimingDelay != 0)
		{
			TimingDelay--;
		}

	}
}

#endif /* DHT_H_ */
