shardikgeek/Greenhouse-Auto/Codigo/DHT11_SAI/src/main.h

/*
 * main.h
 *
 *  Created on: 18 sep. 2018
 *      Author: diego
 */

#ifndef MAIN_H_
#define MAIN_H_

#include "dht.h"
#include "stm32_ub_lcd_2x16.h" // Inclusion de la libreria para manejar el LCD
#include <stm32f4xx.h>
// Variables globales.
struct{
	uint32_t contador;
	uint8_t flag;
}led;

struct{
	uint32_t contador;
	uint8_t flag;
	uint8_t estado;
}display;

// Prototipos de funciones.
void inicializar_leds();
void task_manager(void);


#endif /* MAIN_H_ */
