shardikgeek/Greenhouse-Auto/Codigo/SAI_Alpha1.3/src/SAI_Inits.h

/*
 * SAI_Inits.h
 *
 *  Created on: 13 nov. 2018
 *      Author: diego
 */

#ifndef SAI_INITS_H_
#define SAI_INITS_H_
#include <stm32f4xx.h>

void inicializar_leds(void);
void inicializar_fan(void);
void inicializar_calentador(void);
void inicializar_bomba(void);
void inicializar_ventana(void);


#endif /* SAI_INITS_H_ */
