shardikgeek/Greenhouse-Auto/Pruebas/STM32/Prototipo_0.1/src/sai_estructura.h

/*
 * sai_estructura.h
 *
 *  Created on: 5 sep. 2018
 *      Author: diego
 */

#ifndef SAI_ESTRUCTURA_H_
#define SAI_ESTRUCTURA_H_
#include <stdio.h>
#include "stm32f4xx.h"
#include "adc.h"
#include "stm32_ub_lcd_2x16.h"
void scheduler(void);
void flag_checker(void);
void refresh_display(void);

#endif /* SAI_ESTRUCTURA_H_ */
