shardikgeek/Greenhouse-Auto/(commit log)

2018-04-24 Nombres de sensor
    Agregue el nombre a el sensor de humedad del suelo.
2018-07-18 Script para leer el puerto serie
2018-07-18 YL-69 (bug)
    No se habia igualado promedio a cero al final de cada pasada.
    [Sensor-humedad.ino]
2018-07-19 Formato de los comandos.
    Se agrego un programa .ino para interactuar con el formato de los comandos.
2018-07-19 Sensor de Humedad (STM)
2018-07-19 Tareas de hoy
2018-07-20 Cosas de python
2018-07-23 Nuevos ejemplos STM32
    Agregamos RTC, LCD y systick. Ademas un pequeño control de temperatura con arduino.
2018-07-24 Placa Madre (Esquematico)
    [Placa-Madre-TDII.pdsprj]
2018-07-24 Controles de temperatura
    Agregamos los algoritmos de control de temperatura con arduino.
2018-07-25 Se agrega nueva placa para el PCB
    [Placa-Madre-TDII.pdsprj]
2018-07-25 Cambios en el esquematico
    Se agrego la interfaz para entradas analogicas.
    [Placa-Madre-TDII.pdsprj]
2018-07-26 Tiempos de esta semana
2018-07-26 Detalles en el esquematico
    [Placa-Madre-TDII.pdsprj]
2018-07-26 Menu STM32F4
    Agregamos un pequeño menu con interrupciones y botones.
2018-07-26 Documentos
    Agregue la actividad del dia de hoy y un .docx con info.
2018-07-26 Agregamos los pines al esquematico
    [PlacaMadre3.pdsprj]
2018-07-27 Mejora del menu
    Terminamos un buen ejemplo de lo que puede ser el menu.
2018-07-27 Pruebas STM32
    Agregamos librerias nuevas y un ejemplo de ADC con timer.
2018-07-29 Actualizacion de la placa
    Agregue el conector para la tarjeta SD y el motor DC.
    [PlacaMadre3.pdsprj]
2018-07-31 Prototipo agregado
    Agregamos un bosquejo de un codigo mas completo.
2018-07-31 Prototipo update (STM32)
2018-08-01 Updete Placa Proteus
    [Esquematico_Alvarez_Loidi.pdsprj, Placa-Madre-TDII.pdsprj, PlacaMadre3.pdsprj]
2018-08-01 Placa Madre Update
    [Esquematico_Alvarez_Loidi.pdsprj, Placa Madre.pdsprj]
2018-08-02 Prueba almacenamiento SD
    Enviamos una tabla con valores de temperatura (DHT11) con su respectivo tiempo y guardamos el archivo en .csv
2018-08-02 Comunicacion SD
    Pines de conexion
2018-08-03 Interrupciones STM32
    Agrego un programa que maneja interrupciones por hardware.
2018-08-21 Agrego el esquematico entregado
    [Esquematico_Alvarez_Loidi_TDII.pdsprj]
2018-09-05 Prototipo0.1 agregado
    Se agrega la estructura definitiva del programa. El programa contiene dos ADC, un led y el LCD.
2018-09-05 Cambios en Prototipo
    Se agrega una nueva forma de refrescar la pantalla.
2018-09-11 DHT11 con timeout
    Sensor DHT11 funcionando con timeout se puede conectar y desconectar, solo falta una administracion mas limpia del display.
2018-09-12 Nueva version de Test_DHT11
    Se agrega un timer exclusivo para el delay del dht. Ademas el sistema corre aparte con el Systick a 1ms.
2018-09-25 Agregado Prototipo 1.3
    Este programa ya contiene un seguimiento de cultivos.
2018-09-30 Menu por serial.
    Se agrega un programa en arduino que permite modificar una variable.
2018-10-02 Agregado de USART
2018-10-02 Agrego el Prototipo 1.3
    Tiene el chequeo de fecha.
2018-10-02 Ejemplo de uso del serial con interrupciones
2018-10-27 USART interrupciones
    Se agrega un ejemplo apara usar el usart con interrupciones
2018-10-27 Se agrega Prototipo_2.0
    Este prototipo contiene un programa con la estructura final y el USART.
2018-10-30 Camios en Prototipo_2.0
    Se agrega el RTC y el DHT exterior.
2018-10-30 Ejemplo Tarjeta SD
    Se agrega el ejemplo de la tarjeta sd a 1 bit.
2018-10-30 SD en Prototio_2.0
    Se agrega la escritura de un archivo de prueba. Ahora hay que realizar todo el resto.
2018-11-02 Cambios en Prototipo_2.0
    Se agrega la lectura de un archivo de configuracion de la SD.
2018-11-05 Cambios en Prototipo_2.0 y agregado de la perimer Alpha
    Se agrega la primer alpha con bastantes cambios importantes.
2018-11-05 Agregado de librerias para controlar ventana y ventilador en Prototipo_2.0
2018-11-06 Cambios en Alpha1.0
    Se agrega un log, ahora ya se puede realizar completamente el backup.
2018-11-07 Cambios en Alpha 1.0
    Se agrega el backup de dtaos, por ahora se tiene q activar a mano con el comando :SKR,-,-!
2018-11-10 Placas finales
    1era y 2da Placa
    [Primera-Placa.pdsprj, Segunda-Placa.pdsprj]
2018-11-10 Alpha 1.1
    Agregado de ventana, ventilador y rele por monitor serie
2018-11-11 Cambios en la primer placa
    Se cambio el pin del buzzer.
    [Primera-Placa.pdsprj]
2018-11-12 Agregado de Software
    Se agrega un excel en el cual cargando una maquina de estados, genera un codigo en C. Ademas se hace un menu de ejemplo.
    [FSM-MENU.xls]
2018-11-12 Detalles en las placas
    Ultimos detalles para las dos placas
    [Primera-Placa.pdsprj, Segunda-Placa.pdsprj]
2018-11-12 Ajuste de tamanos de pistas y vias
    [Primera-Placa.pdsprj, Segunda-Placa.pdsprj]
2018-11-13 Cambios en la Alpha
    Se agrega un datalogger y cambio de variables de control en cada etapa.
2018-11-13 Achique unos mm las placas
    [Primera-Placa.pdsprj, Segunda-Placa.pdsprj]
2018-11-14 Agregado de amplificador para el Buzzer
    [Primera-Placa.pdsprj]
2018-11-14 Agregado Alpha1.2 y Alpha1.3
    En el Alpha 1.2 se cambia el datalogger haciendo que cree un nuevo archivo si no se encuentra y que agregue informacion si existe. En el 1.3 se divide el codigo en .c y .h.
2018-11-19 Cambios en Alpha 1.2
    Se mejora un poco el codigo, se agrega el menu simulado por software.
2018-11-25 Comentarios agregados
    [FSM-MENU.xls]
2018-11-26 Nueva BETA
    Se agrega una beta funcionando correctamente. Falta mejorar los botones.
    [adc.c, dht.h, fan.h, fsm.c, fsm.h, fsm_transition.c, main.c]
2018-11-26 Agregado de comandos
    Se agrega un docx con los comandos y las macros.
2018-11-26 Update de macros
2018-11-27 Update en la Beta1.0
    Se añade el menu copete
    [FSM-MENU.xls]
2018-11-27 Se agrega el manual
2018-11-27 Nueva Beta 2.0
    Beta para agregar el DAC
2018-11-30 Manual de Reparación
2018-12-01 Cambios en manuales
    Cambie el formato en los manuales para que sean iguales
2018-12-07 Cambio en orden de funciones
    Se ordenan las funciones en el main.c
