shardikgeek/Greenhouse-Auto/(notices)

Notices in the files:
Pruebas/STM32/Test_Cargar_RTC/src/tm_stm32f4_ds1307.h:
This program is free software: you can redistribute it and/or modify
it under the terms of the GNU General Public License as published by
the Free Software Foundation, either version 3 of the License, or
any later version.
